meryglez529-commits/DAHUASUO/AI-work/LOG.md

# AI-work Log

> 2026-08-05 | DL5_UNIT_007 board ILA PASS | With the qualified recovery-acknowledgement image, the host app stopped/configured/read back/started the 16x16 laser profile: `dac_sample=50`, recovery=5 us, X fall=1 us, scan delay=800 ns, and 20 ns acquisition delay/time. Guarded three-ILA capture proves DAC tail marker/toggle, then State 18 for exactly 625 eth_clk cycles (5.000 us) before the next accepted laser; intervening laser edges were ignored. Laser camera_line_sync is low for the complete 31 us line window and acquisition delay/high each last four ui_clk cycles (20 ns). Hardware-manager run exited 0 with no D-root spill.

> 2026-08-05 | DL5_UNIT_007 qualified build | The physical-flyback recovery RTL was built through implementation and one checkpoint-based physical optimization repair. Final timing is WNS +0.093 ns, WHS +0.048 ns, TNS/THS 0; bitgen completed with 0 error/0 critical warning. The qualified paired files are `DL5_UNIT_007/out/bitstream/ETH_TOP_dl5_recovery_ack_qualified.bit/.ltx`. Added a unit-local guarded ILA plan which captures the DAC tail marker/toggle, eth-domain acknowledgement/recovery state, camera signal, and unchanged acquisition path. The subsequent board result is recorded in the newer log entry; no FIFO IP, register map, XDC, or IO changed.

> 2026-08-05 | DL5_UNIT_007 physical-flyback recovery implementation: Added a laser-only FIFO[32] final-flyback marker, DAC-domain completion toggle, three-FF return CDC, and States 17/18 so the configured recovery starts only after the physical final flyback word updates DAX. The standalone dual-clock regression passed normal, ultrafast, and laser cases; with a 1 us setting, completion-to-State14 measured 1.042 us. No FIFO IP, register map, XDC, or top-level IO changed. Implementation/board verification remains pending.

> 2026-08-05 | DL1_UNIT_002 FIFO[32] and handshake check: Confirmed `fifo_bit32 = laser_mode_en ? 1'b0 : adc_tri`; laser-mode `dac_output` takes ADC trigger from `acq_pulse_ui`, not FIFO[32], so bit32 is functionally spare in laser mode. The existing eth-side generator sees only `para_config_prog_full` and `wr_rst_busy`; it has no reader-empty, DAC-word-consumed, or DAX-level-complete input. Thus current State2 has no hidden physical-output handshake. The recommended acknowledgement changes the eth counter's start event, not its clock domain; counter-only scaling cannot supply that event.

> 2026-08-05 | DL1_UNIT_002 recovery-fix architecture choice: Compared counter-only and physical-completion approaches. Normal mode's State2 is also eth-clocked; its 5 µs physical dwell comes from enqueuing 250 DAC words, not a DAC-domain counter. Scaling laser State2 from 250 to 625 eth cycles is only an unbounded heuristic because its start still overlaps FIFO/DAC flyback. Recommended future fix: preserve FIFO width/depth and sparse recovery writes; make the DAC read side acknowledge actual tail consumption, then count recovery in eth_clk from that acknowledgement (625 cycles for 5 µs). A laser-only FIFO[32] tail marker plus one DAC→eth toggle is the minimal robust implementation; FIFO[32] is already forced to zero and ignored for ADC in laser mode. No RTL changed pending user approval.

> 2026-08-05 | DL1_UNIT_002 recovery defect root cause: State2 itself does correctly ignore laser; the failure is premature State2 exit. `dacx_recovery_time=5` becomes 250 intended DAC words, but laser State2 emits only two anchor words and advances its counter on the 125 MHz FIFO write clock, so it remains in State2 for only 250×8 ns=2 µs. It starts after the tail is generated on the write side, not after that tail has been consumed by the 50 MHz DAC read side. State2 therefore overlaps physical flyback, then explicitly enters State14, which accepts laser. The defect is a write-side timebase/physical-output-completion mismatch, not an unexpected laser transition within State2.

> 2026-08-05 | DL1_UNIT_002 recovery-time clarification: Confirmed the physical distinction in the current 1 µs flyback / 5 µs recovery setup. The next x0 word (also -4 V, hence invisible in DAX) reaches the DAC about 4 µs after the analog flyback reaches -4 V; the next visible x1 step is about 6 µs after it. The first accepted next-line laser occurs even earlier, before x0 output. Thus the current logic violates the required ≥5 µs post-flyback laser-inhibit interval despite a seemingly long -4 V plateau.

> 2026-08-05 | DL1_UNIT_002 step-count and latency review: Confirmed that a 16-pixel X line has 16 stable DAC levels but only 15 visible inter-pixel transitions; x0 equals the post-flyback start code, so its transition is hidden in the recovery plateau. User's live-scope laser-to-visible-DAX delay of ~1.24 µs is consistent with `scan_delay=100` (=800 ns from synchronized laser acceptance to State16 write) plus the fixed CDC/FIFO/DAC-output chain (~0.43 µs). The delay register is not a direct physical output-delay setting.

> 2026-08-05 | DL1_UNIT_002 confirmed laser recovery defect: User clarified the required semantics: with 1 µs X flyback and 5 µs recovery configured, the board must not respond to the first next-line laser until at least 5 µs after flyback completes. Source and ILA/scope evidence show the current laser State2 counter runs concurrently with FIFO/DAC flyback and then accepts laser too early; this is a confirmed RTL defect, recorded as Q22. No RTL changed in this turn.

> 2026-08-05 | DL1_UNIT_002 laser recovery semantics: Source review corrected the earlier shorthand “line-head recovery 5 µs”. Register `dacx_recovery_time=5` is intended to be an additional 5 µs recovery after flyback in normal mode, but laser State2 writes only two anchor FIFO words and counts 250 `eth_clk` cycles (=2 µs). Board ILA measures 5.02 µs from line-end marker to next line-start marker, including ~1 µs flyback and ~4 µs post-flyback hold for this laser phase. This is an implementation semantic deviation to assess separately; no RTL changed.

> 2026-08-05 | DL1_UNIT_002 scope CSV review: Reviewed user exports `F:/smart/csvwave/0909010011.csv` (CH1) and `0909010013.csv` (CH2). CH1 measures a stable 2 µs-period / 1 µs-high laser waveform. Conditional on the user's CH2=DAX probe mapping, CH2 shows the expected 16-code, 2 µs-per-code X line, ~1 µs flyback, and 36 µs line period. The files carry no physical-probe labels and were exported 18 s apart, so they cannot establish laser-to-DAC delay or camera-sync alignment; recorded this limitation in `SCOPE_REVIEW.md`.

> 2026-08-05 | DL1_UNIT_002 board ILA verification: Programmed repair bitstream, applied/read back the proven 16×16 laser profile (`dac_sample=50`, DL5=`100/20/80/30/60`) and started scan. Guarded ILA captured full write-side line, DAC marker/camera alignment and acquisition timing with zero D-root spill. FIFO[34]/[33] aligned with first/last DAX words; camera low window covered the full valid line and released on the first return code. Acquisition delay/width measured 600 ns/1.2 µs as configured. Evidence: `features/camera_line_sync/DL1_UNIT_002/BOARD_VERIFICATION.md`.

> 2026-08-05 | DL1_UNIT_002 implementation: After the focused RTL simulation PASS, rebuilt without changing FIFO/IP/XCI/XDC. `write_bitstream` completed successfully; formal timing WNS=+0.202 ns/WHS=+0.048 ns and all user constraints met. Archived the matched `ETH_TOP_camera_marker_fix.bit/.ltx`, reports, and guarded ILA capture script. Board-level laser capture remains pending user programming and start.

> 2026-08-05 | DL1_UNIT_002 RTL and simulation: Implemented the laser FIFO[34]/[33] marker-register alignment in `parameter_dacdata_gen.v`. The focused real-generator/DAC-output simulation passed at 3630 ns for laser `dac_sample=1/4/50` plus normal/ultrafast regression. After PASS, reused the existing-width DAC ILA probe2 for `{laser_mode, camera_active, FIFO[34], FIFO[33]}`; no FIFO/IP/XDC/register/board change. Implementation and guarded board capture remain pending.

> 2026-08-05 | DL1_UNIT_002 laser-camera repair plan: Created a corrective work package for the confirmed laser FIFO marker-alignment defect. The proposed minimal repair aligns FIFO[34]/[33] with the registered DAX/DAY and `wr_en` pipeline in State16, retains the DAC-domain line state machine, FIFO/IP/XDC/registers and normal/ultrafast behavior, and defines simulation/ILA/scope gates. No RTL, bitstream, or board configuration was changed.

每次 skill 调用或重要改动追加一行。最新的写在最上面。

格式：`YYYY-MM-DD HH:MM | mode | 简述`

---

| 时间 | Mode | 简述 |
|---|---|---|
| 2026-07-02 | host-protocol-ai-assist-design | 调用 fpga-cowork 讨论上位机联调优化：建议以确定性协议解析器/Wireshark 导出为底座，将抓包结构化后交给 AI 做字段解释、期望值对照、异常定位和复现建议；本轮只做方案分析，未修改功能代码。 |
| 2026-07-02 | docs-read-host-co-debug | 调用 fpga-cowork 复核 AI-work 文档，重点梳理上位机环境、UDP 控制面、DL2 数据接收、DL5 L0-L9 联调步骤及文档/源码一致性；仅阅读与记录，不修改 RTL 或上位机功能。 |
| 2026-06-22 12:40 | cleanup-and-skill-push | Cleaned D-root ILA spill: removed 21 empty `D:/hw_ila_data_*` dirs, verified D-root ILA-like dirs/files are both 0. Submitted fpga-cowork upstream update to GitHub repo `meryglez529-commits/fpga-project-reader`, commit `03eac32 Guard Vivado ILA D-root artifacts`, covering guarded Vivado ILA launcher policy and D-root spill archive rule. |
| 2026-06-22 12:25 | ila-artifact-guarded-runner | Added `AI-work/scripts/run_vivado_ila_guarded.ps1` as the required AI-driven ILA Vivado launcher. It runs Vivado batch from a unit-local work dir, writes logs/journals under the selected out dir, snapshots `D:/hw_ila_data_*`, and archives only newly-created D-root spill dirs into `droot_spill/`. Updated ILA_ARTIFACT_CONTROL.md and fpga-cowork skill to require the guarded launcher instead of direct `vivado.bat -source` calls. |
| 2026-06-22 12:15 | ila-artifact-root-cause-repro | Reproduced D-root hw_ila_data spill with Vivado batch. `refresh_hw_device` from `pwd=D:/` created `D:/hw_ila_data_22`; repeat after archiving re-created it. Controlled `upload_hw_ila_data` also created `D:/hw_ila_data_22` despite active pwd under AI-work, so cd alone is insufficient. Root cause: Vivado 2021.1 Hardware Manager ILA data-object handling (`display/get/upload_hw_ila_data`) can emit D-root placeholders. Added repro logs/README, updated ILA_ARTIFACT_CONTROL.md, and added D-root spill auto-archive guards to current capture scripts. |
| 2026-06-22 11:55 | ila-artifact-verification | User challenged Tcl pwd assumption after observing Vivado GUI pwd=C:/Users/Administrator/AppData/Roaming/Xilinx/Vivado. Corrected documentation from proven root cause to working hypothesis and added AI-work/scripts/probe_ila_workdir_behavior.tcl to verify whether refresh_hw_device creates hw_ila_data_* under D:, AppData, or a controlled work dir. |
| 2026-06-22 11:45 | ila-artifact-control | Reframed ILA artifact finding as observed facts plus working hypothesis: D:\ root has 21 empty hw_ila_data_* dirs from 2026-06-18 14:50:51, but current Vivado GUI pwd is C:/Users/Administrator/AppData/Roaming/Xilinx/Vivado, so D-root creation is not proven by current pwd alone. Updated current ILA scripts to resolve proj_root from [info script] and cd to unit-local vivado_hw_work; documented verification test in env/ILA_ARTIFACT_CONTROL.md. |
| 2026-06-22 11:20 | ila-artifact-audit | Scanned D: for ILA artifacts without moving files: D:\ root has 21 empty hw_ila_data_* dirs and no loose .ila/.wdb/.wcfg/.vcd/.csv/.bit/.ltx files; current project ILA evidence is mainly under AI-work/out plus Vivado-managed .Xil and AXI_DDR.hw wave/backup state; large unrelated cache is under stable_version projects. |
| 2026-06-22 10:45 | ultrafast-sync2-rtl-check | 检查超快模式 sync1 有输出、sync2 无输出现象相关 RTL：当前源码中 `sync2_pixel_tri_wigth` 写地址为 `0x0205`、读回同地址；若 `0x0205` 保持 reset 默认 1 或被写成 0/1，`parameter_dacdata_gen` 源脉冲/`dac_output` 整形器不会产生可见 sync2。顶层 `TRIGGER_OUT=sync_pixel_tri2` 直连，sync2 高有效；优先读回 `0x0205` 并用 ILA 看 `sync2_pixel_tri_r1/sync2_state/sync_pixel_tri2_reg`。 |
| 2026-06-22 10:10 | DL5-UNIT005-cleanup | 整理散落运行产物：工程根目录 `vivado*.log/.jou/.str`、`xvlog.pb`、`xsim.dir` 归档到 `DL5_UNIT_005/out/artifact_cleanup_20260622/project_root/`；非 unit 的 `AI-work/features/DL5_laser_sync/ila/*.csv/*.vcd` 归档到 `DL5_UNIT_005/out/artifact_cleanup_20260622/legacy_feature_ila/`；未移动 Vivado 管理目录 `.Xil/`、`AXI_DDR.hw/`、`AXI_DDR.runs/`、`AXI_DDR.sim/`。 |
| 2026-06-18 16:18 | DL5-UNIT005-board | Built and programmed fixed DL5 bitstream; `impl_1` write_bitstream PASS with WNS 0.007947 ns/WHS 0.049464 ns. ILA `hw_ila_9` after host parameter setup captured one `adc_tri_r1`, one 10-sample `acq_en` window, then `state=0` for the rest of capture. |
| 2026-06-18 15:24 | DL5-UNIT005-fix | Fixed DL5 laser-mode ADC free-run in `adcdata_acq.v`: non-row-end laser windows now return to trigger-wait state; added focused Vivado/xsim regression under `DL5_UNIT_005`, result PASS with logs/WDB in `out/sim/`. |
| 2026-06-12 17:40 | host-app-adc-image | Implemented ADC imaging v1 host side: DL2 AA55 parser, UDP 32001 receiver, frame assembler, channel-count-to-bitmask mapping, ADC Imaging GUI tab, mock image display, and protocol/channel tests. |
| 2026-06-12 17:05 | rtl-protocol-read | Checked `line_count/line_count_en`: generated in ADC acquisition for ultrafast/laser row completion, but `LAN_TX_FREAME` only emits `CC55` line-count packets when `ultrafast_mode==1`; laser imaging can initially rely on AA55 frame byte reconstruction. |
| 2026-06-12 16:45 | data-path-read | Read ADC imaging path for host-app planning: `adcdata_acq` trigger/average, `adcdata_get` channel packing, DDR FDMA buffering, `LAN_TX_FREAME` AA55 packetization, and existing host `core/data` stubs. |
| 2026-06-12 15:20 | host-app-gui | 重新核对 ADC 量程映射：不再只依据 `ETH_TOP.v` 的乱码注释，而是结合 `sem-scsg2450-afea-v10(2).pdf` AIN1~AIN4 原理图页，确认硬件继电器状态 `RL1/2` 为 `00=+/-5V`、`01=+/-2.5V`、`1x=+/-1.25V`；再套用 RTL `AINx_RELAY={~(|adc_gain), adc_gain[0]}`，得到 GUI code 显示应为 `0->+/-1.25V`、`1->+/-2.5V`、`2->+/-5V`、`3->+/-2.5V(same)`。已更新 ADC 下拉框，默认 code2 显示 `+/-5 V`。验证：compileall PASS、23 项 unittest PASS、Qt offscreen 检查 ADC/DAC 下拉文本和底层 code 正确。 |
| 2026-06-12 14:39 | host-app-gui | 核对 RTL 后更新 GUI ADC/DAC 量程显示：`ETH_TOP.v` 中 ADC `0x0003` code 控制 AINx 继电器，注释映射为 `00=5V/1/2x`、`01=2.5V`、`1X=5V`，因此 ADC 默认 code2 显示为 `5 V (1x)`；DAC `dac_gain[1]` 控制 `AOUTx_CON` 量程组、`dac_gain[0]` 进入 `ad9747_cfg.v` 选择 12.5mA/25mA，GUI 显示为 `1.25 V/2.5 V/5 V/10 V`，默认 code3 显示为 `10 V`。底层写入 code 不变。验证：默认 Python 与 `D:\fpga_host_venv` 均 compileall PASS、23 项 unittest PASS；Qt offscreen 确认 ADC/DAC 文本和底层 code 正确且 1120x752 无横向滚动。 |
| 2026-06-12 11:38 | host-app-gui | 取消 GUI 数字输入框的上下箭头步进按钮：模式工作台、顶部连接栏和高级调试旧面板中的所有 `QSpinBox` 均设置为 `NoButtons`，保留键盘直接输入，避免白色箭头控件突兀且减少误点加减 1。验证：默认 Python 与 `D:\fpga_host_venv` 均 compileall PASS、23 项 unittest PASS；Qt offscreen 检查完整窗口 32 个 SpinBox 均为 NoButtons，1120x752/1920x1080 横向滚动最大值仍为 0。 |
| 2026-06-12 11:32 | host-app-gui | 根据反馈收敛 GUI 配色：撤掉参数组大面积浅色和粗彩色边框，恢复中性仪器灰白底；仅保留关键交互点颜色标识，包括默认/应用参数按钮、开始扫描、停止扫描、模式/参数状态 chip 与 dirty 参数行。验证：默认 Python 与 `D:\fpga_host_venv` 均 compileall PASS、23 项 unittest PASS；Qt offscreen 检查默认激光参数仍正确，1120x752/1920x1080 横向滚动最大值仍为 0。 |
| 2026-06-12 11:28 | host-app-gui | 设置 GUI 激光联调默认值并优化视觉层次：默认进入“激光同步”，参数设为已上板验证的小帧配置（rows=6、cols=8、ADC 通道=1、X/Y 全幅、recovery=1us、fall=1us、scan/blanker/acq 时序均为 10）；增加全局 Fusion/QSS 样式，按参数组设置轻量色条和浅底色，减少单调灰；压缩顶部连接栏 IP/端口/按钮宽度，缓解窄窗口挤压。验证：默认 Python 与 `D:\fpga_host_venv` 均 compileall PASS、23 项 unittest PASS；Qt offscreen 检查 1120x752/1920x1080 默认值正确且横向滚动最大值为 0。 |
| 2026-06-12 11:19 | host-app-gui | 二次收紧上位机单页布局：压缩参数行 label/unit/hint 宽度和 group 边距，保持 3 列但避免 1120 宽度横向溢出；将“激光使能”合并到“激光同步 / 时序”组第一行；点击日志“清除”时同步清空底部 status 文案，避免误认为日志未清。验证：默认 Python compileall PASS、23 项 unittest PASS；`D:\fpga_host_venv` 下 compileall PASS、23 项 unittest PASS；Qt offscreen 检查 1120x752 与 1920x1080 下模式页横向滚动最大值均为 0。 |
| 2026-06-12 11:09 | host-app-gui | 按现场调试反馈调整上位机 GUI：模式工作台移除内层“共用参数/模式参数”双页，改为单页滚动布局，三列压缩共用参数并在下方直接显示当前模式参数；日志面板新增“清除”按钮并限制最多保留 500 行，计数随保留日志同步；去掉 REAL 模式下“应用参数/开始扫描”的反复确认弹窗。验证：默认 Python compileall PASS、23 项 unittest PASS；`D:\fpga_host_venv` 下 compileall PASS、23 项 unittest PASS、Qt offscreen smoke PASS。 |
| 2026-06-12 10:56 | host-app-board-debug | 核对 RTL 中 `dax_fall_us` 1us/2us 对下降回扫的影响：`command_monitor_new.v` 将 GUI 值写入 `0x000F`，`dacdata_config.v` 内部 x50 转为 FIFO word，因此 1us=50 word、2us=100 word；`parameter_dacdata_gen.v` State 12/13 下降段单调减 `dax_fall_step`，但 laser 模式 State 13 限速为约 3 个 eth_clk/word（约 41.67MHz）低于 `dac_output.v` 的 50MHz 读侧，2us 更容易耗尽 FIFO 余量并触发 `prog_empty` 读暂停，表现为 DAX 下降段保持/不均匀/毛刺；建议 ILA 对比 1us/2us 捕获 `para_config_wr_en/prog_empty/rd_en/DAX_DATA/current_state/dax_fall_cnt/s13_wait_cnt`。 |
| 2026-06-12 10:49 | host-app-board-debug | 解释 DAX 行尾下降和行首恢复时间：GUI `dax_fall_us` 写 `0x000F`，`dacdata_config` 内部 x50 转 FIFO/DAC word，名义上 1us->50 word、2us->100 word；GUI `dacx_recovery_us` 写 `0x0006[15:0]`，`parameter_dacdata_gen` 内部同样 x50。用户将两者从 2us 改到 1us 后，示波器光标量到下降约 1.020us，符合预期；laser 模式下行首恢复期间会忽略 laser，DAX 低平台还可能包含恢复结束后等待下一次 laser 的时间。 |
| 2026-06-12 10:42 | host-app-board-debug | 解释当前 laser 配置下最后一个 DAX 台阶宽度：`--dac-sample 20` 决定 State 16 写 20 个 DAC FIFO word，按约 20ns/word 预计最后台阶保持约 400ns；行内非最后台阶还会在 State 14 等下一次 laser 时继续保持，因此看起来更长。用户图中约 440ns 的最后台阶与该预期量级一致。 |
| 2026-06-12 10:34 | host-app-board-debug | 用户更新新 bitstream 后，host-app `mode laser apply` 和 `start` 均成功，`0x0009=0x00000011` running。示波器图显示 CH2 laser 触发下 CH1 DAX 呈 `cols=8` 对应的 8 级台阶，行末出现回扫/下降后进入下一行，形态与 `parameter_dacdata_gen` 激光模式 State 14/15/16 -> State 4 -> State 12/13 的预期一致；建议继续用光标确认 laser->DAX 首台阶延时约为 `scan_delay=10` 的 80ns 加 FIFO/DAC 输出链路固定延迟，并用 TRIG_BLANK/ADC acq 进一步闭环。 |
| 2026-06-12 10:01 | host-app-board-debug | 查看用户 GUI 日志：version 读回 `0x000300AC`，但 `mode laser apply` 失败。dry-run 展开当前写入计划为 22 个 checked-write；源码 `command_monitor_new.v` 已按 `0x020B=laser_mode_en`、`0x0200~0x0205` 读回更新，但当前 `ETH_TOP.bit` 时间戳为 2026-06-05 09:55，早于 2026-06-11 的寄存器协议源码更新，判断板上 bitstream 大概率仍是旧协议，需重出/重烧 bitstream 或临时按旧 `0x0205=laser_mode_en` 调试。 |
| 2026-06-11 15:45 | feature-host-app-param-gui | 准备提交到 GitHub：本次提交聚焦 `command_monitor_new.v` 读回表、host-app 参数模型/CLI/GUI 两页重构、参数单位/地址文档和测试；不包含无关 `skill-improvements` 与 artifact cleanup 工作区文件。 |
| 2026-06-11 15:25 | feature-host-app-param-gui | GUI 参数区改为两页：`共用参数` 包含图像/采样、扫描区域、时序、增益/行帧；`模式参数` 随普通/超快/激光切换；移除可编辑 scan_mode，固定 code 1；DAC X/Y 起止改为 0..cols-1 / 0..rows-1 人类坐标并在 GUI 内转 16-bit DAC code；超快/激光不再使用普通 adc_interval。 |
| 2026-06-11 14:45 | feature-host-app-param-gui | 复查 GUI 参数语义：核对 `adc_interval`、`scan_mode`、DAC X/Y code 到顶层取反输出、`dacx_recovery_time/dax_fall_time` x50、`frame_waiting_time`、`row_m/row_n` 交错扫描，以及激光模式 `acq_data_delay_time` 与 ADC 采集延时分层关系。 |
| 2026-06-11 14:10 | feature-host-app-param-gui | 按 `UX_REDESIGN_PLAN.md` 实现 host-app GUI V1：窗口标题去 Qt backend、顶部连接栏分组、模式下拉替代左侧单选、普通模式隐藏空扩展页、参数页重分组并外显单位/换算、运行控制上移、写入计划/日志改抽屉；`compileall` PASS、23 项 `unittest` PASS、Qt offscreen smoke PASS。 |
| 2026-06-11 13:05 | feature-host-app-param-gui | 检查当前 PySide6 GUI 与用户列出的 UX 问题，新增 `UX_REDESIGN_PLAN.md`：给出顶部栏、模式下拉、参数 metadata、动态 Tab、运行工作条、写入计划/日志抽屉的重构方案；同步修正 `PARAM_UNITS_AUDIT.md` 中 `0x0205` 读回旧备注。 |
| 2026-06-11 12:35 | feature-host-app-param-gui | 补 `command_monitor_new.v` RTL 读回表：`0x0200~0x0205` sync/ultrafast 与 `0x020B` laser enable 可读回；host-app register map/mode plan 改为 checked write；清理 host-app 架构/UX/ready 文档中对应旧不可读回描述；`compileall`、23 项 `unittest`、laser dry-run PASS。 |
| 2026-06-11 12:10 | feature-host-app-param-gui | HOSTAPP_UNIT_001：按当前 `command_monitor_new.v` 写表更新 host-app 地址与参数模型（`0x0205=sync2_width`, `0x020B=laser_mode_en`），补 gain/frame/row 参数、GUI 分组与单位标签、CLI help、单位审计文档；`compileall` PASS，23 项 unittest PASS，laser/ultrafast dry-run 确认 write-only 地址 unchecked。 |
| 2026-06-11 10:00 | single-file-close-read | 精读 `command_monitor_new.v` 的 DL4 写/读寄存器表，并对照 `AI-work/host-app` 当前 GUI/CLI/mode 写入计划；新增 `AI-work/host-app/COMMAND_MONITOR_PARAM_COVERAGE.md`，标出普通扫描已覆盖参数、raw-only 参数，以及当前 RTL `0x0205/0x020B` 与 host-app 的 DL5 laser enable 地址冲突；未修改 RTL/host-app 代码。 |
| 2026-06-11 09:52 | context-read | 使用 AI-work 平台复核工程地图与 host-app：确认当前顶层 `ETH_TOP`、DL1~DL5 链路状态；检查 `host-app` 架构/代码/配置，运行 21 项 unittest、`compileall`、Qt import、normal/laser dry-run 和 DL2 mock-frame；未修改 RTL 或 host-app 代码。 |
| 2026-06-05 12:37 | artifact-cleanup | 整理 D 盘、`D:\SGSC_SEM_dahuasuo_325T_V3_172` 和工程根散落运行产物：57 项约 190.72 MB 移入 `AI-work/reports/artifact-cleanup-2026-06-05/`，清单见 `AI-work/env/ARTIFACT_CLEANUP_2026-06-05.md`；保留 Vivado 工程内部目录、安装包、压缩包和参考文档。 |
| 2026-06-05 11:57 | skill-improvement | 接替并完成 `fpga-cowork` skill 改进收口：将原 `fpga-project-reader` skill 改名为 `fpga-cowork`，按 DL5_UNIT_002 原型固化 Mode 5 阶段式闭环、Mode 4 项目级仿真 SOP、feature 工作包模板、validator 和产物散落扫描基线选项；未修改 RTL。 |
| 2026-06-05 10:45 | DL5-UNIT004-board-verify | Completed board-level ILA measurement for `laser_pulse_ui -> acq_delay -> acq_pulse_ui/acq_time`: cfg `0x0005000A`, delay counter `0..19` (20 ui_clk cycles), acq counter `0..39` (40 ui_clk cycles), result PASS. Added export script and final measurement docs. |
| 2026-06-05 09:32 | DL5-UNIT004-sim | Completed DL5_UNIT_004 full Vivado/xsim regression after auditing DUT-vs-testbench contract. TC1-TC15 PASS, total errors 0, RTL unchanged in this completion pass; patched regression TB/script handling for line_count contract, auto-row acquisition, acq_time edge counting, and PASS marker parsing. |
| 2026-06-05 09:14 | DL5-UNIT004-audit | Audited simulation and ILA evidence for DL5_UNIT_004: full regression result is FAIL; short smoke sim PASS only; adcdata1_acq ILA probes enumerate on hw_ila_9 but latest batch capture has no CSV and reports debug-core/trigger failure. |
| 2026-06-03 19:30 | DL5-UNIT003-board-debug-closed | **DL5 上板调试闭环**：blanker 无输出 → 逐层定位出两个独立问题并全部解决。(1) **host-app 漏写扫描几何寄存器**：`ScanConfig.to_registers()` 只写 `0x0001/0x0002/0x0004/0x0009`，从不写 `0x0005/0x0006/0x0007/0x000F`，导致 `0x0006` 不写 → `dacx_step` 除法器(`dacx_step_flag`)从不触发 → DAX 恒 0x8000、普通模式 DAC 也无波形。修 `scan.py`+`modes.py`(补全几何寄存器，固定内置默认值)，21 单测过。(2) **D15/laser_sync_in 硬件输入问题**：ILA 直抓 `TRIGGER_IN_IBUF` 实测恒 0(对照内部注入脉冲 33 个完美上升沿)，铁证锁定板级物理层；用户修复硬件后复测 `TRIGGER_IN_IBUF` = 500kHz/20%/2µs，与信号源吻合。mux 改回真实 `TRIGGER_IN` 端到端验证：示波器 TRIG_BLANK 有输出，ILA 实测 laser_sync_in 20% 占空比、laser_toggle 翻转、状态机 14→15→16→4 循环、blanker 整形器输出正常。延迟指标上板实测与仿真吻合(blanker 脉宽 500ns、laser→DAX ~256ns vs 仿真 274ns、跨行 20ns vs 仿真 48ns、FIFO 水位 80% 在地板)。清理全部调试代码(顶层注入+ila_top_trig+dl5_dac_diag)，重出正式 bitstream |
| 2026-06-03 09:51 | DL5-UNIT003-board-bringup | bitstream 烧录后开始实板 L0-L5 联调：`192.168.1.8` ping/UDP version 通，版本 `0x000300AC`；先 `stop` 得到 `0x0009=0x00001310`，随后写入激光模式并启动，参数读回为 `0x0205=1, 0x0206=10, 0x0207=100, 0x0208=100, 0x0209=30, 0x020A=25`，扫描状态 `0x0009=0x00000011`；等待示波器确认 D15、TRIG_BLANK、TRIGGER_OUT |
| 2026-06-02 17:20 | host-app-L0-L9-readiness | 检查 `AI-work/host-app` 对 DL5_UNIT_003 L0-L9 上板验证的支持度：21 项 unittest 通过，CLI dry-run 确认普通/激光模式写入计划正确；新增 `HOST_APP_L0_L9_READINESS.md`；同步修正 `BOARD_DEBUG_GUIDE.md` 中版本寄存器和 DL5 地址旧表（laser_mode_en 为 0x0205，version 为 0x000A） |
| 2026-06-02 17:11 | DL5-UNIT003-docs | 更新 `BOARD_DEBUG_GUIDE.md`：明确当前状态为 route_design 已通过、下一步直接 write_bitstream；修正原文中把 `run_implementation.tcl` 当作 bit 生成脚本的问题；新增 `run_bitstream.tcl` 用于生成并归档 `ETH_TOP_unit003.bit` |
| 2026-06-02 17:03 | DL5-UNIT003-impl | 新增并运行 `run_implementation.tcl`，`impl_1` 跑到 `route_design Complete!`（12 分钟）；routed timing 通过：WNS=0.091 ns、TNS=0、WHS=0.052 ns、THS=0，0 setup/hold failing endpoint；bus skew 全部正 slack；`laser_sync_in` NSTD/UCIO DRC 未复现，下一步可 write_bitstream |
| 2026-06-02 16:26 | DL5-UNIT003-synth | 复用 `TRIGGER_IN`/D15 后重跑完整 synthesis：`synth_design` 完成，0 ERROR / 0 CRITICAL WARNING；旧 `laser_sync_in` NSTD/UCIO DRC 已消除；synthesis WNS 仍为 -0.622 ns，最差 setup 路径为 `U6/N1/step_count_reg[15]` → `U6/N1/day_level_reg[63]`，记录为 implementation 前的时序风险 |
| 2026-06-02 15:45 | DL5-UNIT003-pin-reuse | 按用户确认复用 `TRIGGER_IN`/D15/LVCMOS33：普通/超快模式保留原 TRIGGER_IN 行触发语义，激光模式下同一物理输入作为 `laser_sync_in`；移除顶层独立 laser_sync_in 物理端口，Q19 resolved |
| 2026-06-01 10:47 | host-app-gui-safety | 落地 UI 第一性原则中的 P0/P1：模式工作台新增参数 dirty 状态、失败态 start 防护、REAL 模式 apply/start 确认、`0x0009` scan 状态读回、GUI 操作等价 CLI 日志、写入计划地址展开开关；连接栏新增网络诊断；验证 21 项 unittest、compileall、CLI mode dry-run、GUI 行为小测试通过 |
| 2026-06-01 10:35 | host-app-ui-principles | 参考 ISA-101、FDA human factors、LabOne、Windows design basics、Qt HMI 资料，从第一性原理重新梳理上位机 UI；新增 `HOST_APP_UI_FIRST_PRINCIPLES.md`，明确 UI 是仪器控制台而非寄存器编辑器，并定义状态、模式、日志、防错、DL2/3 扩展和验收标准 |
| 2026-06-01 10:01 | host-app-gui-v2 | 按用户确认实施 GUI V2：新增模式工作台和顶部连接栏，主流程改为普通扫描/超快扫描/激光同步三种模式；raw register console 移到高级调试；补齐 V2 实现记录，验证 21 项 unittest、compileall、CLI mode dry-run、GUI instantiate 均通过 |
| 2026-06-01 09:48 | host-app-ux-plan | 根据用户试用 GUI 反馈，新建 `HOST_APP_GUI_UX_V2_PLAN.md`：将 V2 GUI 定位为以人为本的三模式工作台（普通/超快/激光），主流程隐藏寄存器地址，寄存器控制台降级为高级调试；补充三种模式的参数、写入流程、防呆规则和 V2-P0~P7 改造计划 |
| 2026-06-01 09:40 | host-app-env | 检查并安装上位机 Python 环境：系统 Python 3.12.10/64bit 可用；因工程路径过长导致本地 `.venv` 安装 PySide6-Essentials 触发 long path，改用短路径 `D:\fpga_host_venv`；已安装 editable `fpga-host 0.1.0`、PySide6_Essentials 6.11.1；CLI、GUI import、UDP 32000 bind、17 项 unittest 均通过；新增 `HOST_APP_ENVIRONMENT.md` 实板测试命令 |
| 2026-06-01 09:10 | host-app-implementation | 实现 `AI-work/host-app` 第一版 P0-P6：Python package 骨架、DL4 protocol/register map/register client、real UDP + mock transport、scan/DL5 device API、CLI、PySide6/PyQt GUI 面板、DL2 data-plane stub/mock、configs 和 unittest；17 项单测通过，CLI mock 验证通过；当前环境缺少 Qt binding，GUI 未启动实测，真实 FPGA UDP 未接板实测 |
| 2026-05-31 14:16 | host-app-architecture | 新建 `AI-work/host-app/HOST_APP_ARCHITECTURE.md`：固化 PySide6/PyQt 上位机的分层架构、目录骨架、core/GUI/CLI/mock 边界、DL4 协议模块、DL2 数据平面预留、测试策略和开发阶段；在选型文档中补充架构文档链接 |
| 2026-05-30 17:21 | host-app-planning | 固化上位机第一版技术栈决策：Python Qt 路线（PySide6 优先、PyQt 备选）、原生 CLI、mock 模式、第一阶段不打包 exe；补充 DL2 快速接入的 control/data 分层和后台 worker/帧模型预留要求 |
| 2026-05-30 17:19 | host-app-planning | 根据用户倾向更新上位机选型文档：记录 Qt 路线，并区分 C++ Qt 与 PySide6/PyQt 两个分支；新增 mock 模式说明、模拟范围和工程价值 |
| 2026-05-30 17:18 | host-app-planning | 根据用户补充的 AI 协作需求，更新上位机选型文档：第一版明确为 GUI + 原生 CLI + 共享核心库，并记录 CLI 命令草案、JSON/dry-run/mock 等要求及 CLI-Anything 后续定位 |
| 2026-05-30 17:02 | host-app-planning | 新建 `AI-work/host-app/HOST_APP_DISCUSSION_AND_TECH_SELECTION.md`，记录上位机第一版范围、DL4 协议约束、技术选型候选方案、推荐路线和待用户决策问题 |
| 2026-05-30 16:49 | DL4-doc-update | 补充 `DL4_REG_CONTROL_DEEP_READ.md` 的上位机开发协议说明：网络端点/端口绑定、payload 编解码、读写确认策略、寄存器模型、普通扫描和 DL5 配置流程；同步更新 0x0205~0x020A 读写表 |
| 2026-05-30 16:45 | DL4-protocol-read | 阅读 DL4 寄存器控制链路和以太网协议栈源码，确认 UDP 32000 双向寄存器协议、payload 格式、读回格式、端口过滤和上位机绑定要求；未修改 RTL |
| 2026-05-30 16:39 | context-read | 阅读 AI-work 工作区，补充当前项目理解；重点核对 FPGA_PROJECT_GUIDE、env、DL1~DL5 文档与 UNIT_002 仿真记录，未修改 RTL |
| 2026-05-27 18:35 | DL5-UNIT002-plan | 补充 `DL5_UNIT_002/WORK.md` 实现方案草案：推荐复用 `0x020A` 为 `scan_delay_time`，由 `laser_sync_in` 触发 scan/blanker/acq 三窗口，`Scan_X_Signal` 仅作内部脉冲，`parameter_dacdata_gen` 由 scan_x 触发写 `dac_sample` 长度 FIFO burst；未修改 RTL |
| 2026-05-27 18:20 | DL5-UNIT002-requirements | 根据 PDF 截图和用户纠偏更新 `DL5_UNIT_002/WORK.md`：确认 dwell time 来自 `dac_sample`，每个 `laser_sync_in` 边沿后经 `scan delay` 产生 `Scan_X_Signal` 控制 DAC 坐标赋值，同时产生 blanker/acq 三窗口；未修改 RTL |
| 2026-05-27 18:03 | DL5-UNIT002-docs | 用户确认 UNIT_001 需求方向偏差；整理 UNIT_001 为历史实现包，并新建 `features/DL5_laser_sync/DL5_UNIT_002/` 作为第二轮需求对齐入口，当前未修改 RTL |
| 2026-05-27 14:40 | DL5-sim-replay | 验证 `features/DL5_laser_sync/DL5_UNIT_001/sim/run_batch.tcl`：脚本临时切 `target_simulator=XSim`，Vivado 2021.1 复跑 TC1-TC8 PASS，重新生成 `out/sim/result.txt`、`xsim.log`、`vivado_run_batch.log`、`waveform.wdb` |
| 2026-05-27 14:22 | DL5-doc-recovery | 按 `skill-improvements/fpga-project-reader-doc-management.md` 第 10 节补救 DL5：新建 `features/DL5_laser_sync/DL5_UNIT_001/`，整理 `WORK.md`、`RTL_REVIEW.md`、`SIM_REPLAY.md`、仿真/综合证据、Vivado replay Tcl，并把旧 `DL5_LASER_SYNC_MODE_DESIGN.md` 改为归档入口 |
| 2026-05-27 09:39 | env-maintenance | 通过真实 `winget.exe` 安装并验证 Python 3.12.10；`python`/`py`/`pip`/`winget` 在模拟新终端 PATH 下均可按命令名找到；回填 `ENVIRONMENT.md` |
| 2026-05-27 09:19 | env-maintenance | 更新 `ENVIRONMENT.md` / `SNAPSHOTS.md` 中的工程根路径为当前 `D:/SGSC_SEM_dahuasuo_325T_V3_172/.../fpga_prj`；当时 PATH 里的 Python/winget 均表现为 WindowsApps 占位入口，后续改用 App Installer 包内真实 `winget.exe` 处理 |
| 2026-05-22 17:24 | DL5-impl | Step 8c 完成：full synth_1 PASS（BUILD PASS, synth_design Complete），0 ERROR / 0 CRITICAL WARNING（整个综合日志）。资源占用：LUT 31.94%、Reg 27.19%、IOB 70.50%（+1 = laser_sync_in）、BRAM 89.89%（pre-existing，与 DL5 无关）、DSP 1.90%。Step 7 集成 sim 跳过（综合等价覆盖了接线/CDC 验证） |
| 2026-05-22 17:18 | DL5-impl | Step 8b 完成：RTL elaboration PASS（synth_design -rtl on AXI_DDR.xpr），0 ERROR / 0 CRITICAL WARNING，`laser_sync_blanker_ctrl` 干净综合，`laser_sync_in` 在顶层 port list。剩余 warning 均为 pre-existing（adcdata_config.data_en 未连接等） |
| 2026-05-22 17:15 | DL5-impl | Step 2~6 完成：parameter_dacdata_gen.v 加 laser mode 分支 + laser_pixel_written 标志；dac_output.v 加 4 个 DL5 输入端口 + 3 处 mux（adc_tri/sync1/sync2）+ ui_clk→dac_dco 同步；dacdata_config.v 例化 laser_sync_blanker_ctrl + 完整 CDC（双 FF + ASYNC_REG，toggle-FF pulse 同步）；command_monitor_new.v 加 6 个寄存器（0x0205~0x020A）+ 读写解码；ETH_TOP.v 加 laser_sync_in 顶层端口 + 6 个 wire。全部 xvlog 语法过 |
| 2026-05-22 17:00 | DL5-impl | Step 1 完成：新增 `laser_sync_blanker_ctrl.v`（3 态状态机 + 3 级 FF CDC + scan_state 门控）和 `tb_laser_sync_blanker_ctrl.v`（TC1~TC8）。xsim 跑通，8/8 用例 PASS，0 错误。仿真总时长 ~36us，wall-time < 1min |
| 2026-05-22 18:00 | design | DL5 v3：用户拍板 3 个 P0 决策（时钟用 ui_clk / blanker 低有效 / acq_data_delay_time 新建独立寄存器）。R1 用读 dac_output.v 现场确认（自保持 DAX/DAY）。文档对账"adc_tri 引脚"实际无 IO、纠正物理引脚名为 TRIG_BLANK / TRIGGER_OUT。Q13~Q14 已 resolved；新增 Q15~Q18 |
| 2026-05-22 17:30 | design | DL5 v2 修订：状态机改并行 3 态、新增 laser_period 寄存器（方案 B 切像素）、blanker/adc_tri/sync IO 全部复用现有引脚（仅 Laser Sync 新增 1 个输入）、sync2 语义=laser_event_busy。OPEN-QUESTIONS 加 Q12~Q14 |
| 2026-05-22 16:30 | design | DL5 飞秒激光同步模式架构 v1。用户决策：1 脉冲=1 像素 / IO 暂占位 / sync 跟随激光 / 不做超时。修正 acq 步进 20ns（原稿误写 5ns）。产出 guide/data-paths/DL5_LASER_SYNC_MODE_DESIGN.md |
| 2026-05-22 15:35 | annotation+focus | 对比 parameter_dacdata_gen 新旧版（旧版备份 vs 当前工程）：识别 3 项新增功能（sync_pixel_tri1/2、ultrafast 模式、dac_sample 32-bit）+ FIFO 35-bit。产出 annotations/parameter_dacdata_gen-diff.md，更新 FOCUS.md。用户意图：在新版基础上**新增一个新功能**（具体待告知） |
| 2026-05-22 15:10 | cowork-setup | Step 7: **RULES.md confirmed by user**。Mode 4 setup 完成，可进入闭环 |
| 2026-05-22 15:00 | cowork-setup | Step 6: check_env.tcl PASS（log 见 sim_out/check_env.log），SGMII license OK，1096 源文件齐全 |
| 2026-05-22 14:15 | cowork-setup | Step 5: 回滚演练通过（改 LOG.md → git checkout 还原），baseline tag = baseline-pre-cowork |
| 2026-05-22 14:14 | cowork-setup | Step 4: 复制 5 个 TCL 模板到 AI-work/scripts/，加 customization 头 |
| 2026-05-22 14:13 | cowork-setup | Step 3: 写 env/ 六份 .md（ENVIRONMENT/HARDWARE/RULES/FOCUS/SNAPSHOTS/GLOSSARY） |
| 2026-05-22 14:11 | cowork-setup | 挪旧产出：FPGA_PROJECT_GUIDE.md + 4 份 DL*_DEEP_READ.md + 2 份 HTML 到 AI-work/guide/，ADC_SPI_CONFIG_READ.md 到 annotations/ |
| 2026-05-22 14:10 | cowork-setup | Step 5: git init + commit baseline + tag baseline-pre-cowork（commit df52990） |
| 2026-05-22 14:08 | cowork-setup | Step 2: 用户回答 4 个关键问题（git/挪旧产出/DAC 焦点/xsim） |
| 2026-05-22 14:05 | cowork-setup | Step 1: 工具链探测完成（Vivado D:/Xilinx/Vivado/2021.1 OK；ModelSim 路径失效；GBK/UTF-8 混合；314GB 磁盘） |
| 2026-05-22 14:00 | bootstrap | 创建 AI-work 骨架，启动 Mode 4 co-work setup |
| 2026-08-03 | Mode 2 review | Reviewed the existing AI-work DAC package and re-traced the current RTL path for FIFO bits [34:33] (`sync_pixel_tri2/1`) through `dac_output` to TRIGGER_OUT/TRIG_BLANK; no RTL changes. |
| 2026-08-04 | DL1_UNIT_001 route result | Fresh project-managed synthesis passed (1m47, 0 ERROR/0 CRITICAL WARNING); `impl_1` completed through route_design with WNS +0.119 ns, WHS +0.053 ns, TNS/THS 0. No bitstream was generated. Routed reports and Vivado logs were archived under the unit. |
| 2026-08-04 | DL1_UNIT_001 bitstream | User authorized `write_bitstream` from the timing-closed routed implementation. Vivado completed successfully (0 ERROR/0 CRITICAL WARNING); `ETH_TOP.bit`, `.bin`, `.ltx`, logs, and status were archived under the unit. No Hardware Manager or board operation was performed. |
| 2026-08-04 | DL5 protocol diagnosis | Board symptom review found the legacy host writes laser enable at 0x0205, while current RTL maps 0x0205 to sync2 width and accepts laser_mode_en only at 0x020B. With 0x020B left zero, ETH_TOP gates TRIGGER_IN/D15 to zero for laser_sync_in; normal scan can still work. No RTL change made. |
| 2026-08-04 | DL5 live register read | Read the connected board through the project host app (read-only): version 0x000300AC, scan control 0x00003211, DL5 0x0206..0x020B = 100/20/80/30/60/1. Current laser_mode_en is asserted and timing values match dl5_test, so the stale-0x0205 hypothesis is ruled out for this live board state. |
| 2026-08-03 | architecture review | Evaluated a dedicated camera-sync output spanning normal, ultrafast, and laser modes. Proposed a mode-independent camera event plus ui_clk pulse shaper and a new physical output; no RTL changes. |
| 2026-08-03 | camera-line-sync analysis | Confirmed normal/ultrafast scan streams State 3 pixels continuously per line, whereas laser mode waits in State 14 and emits one State 16 pixel sequence per accepted laser edge. Refined proposal to a DAC-clock-domain line-valid sideband that holds through laser inter-pulse gaps; no RTL changes. |
| 2026-08-03 | camera-line-sync requirements | User confirmed camera line-sync: active-low, covering only valid pixels, asserted/deasserted once per scan line. Physical output pin and row-repeat interpretation remain to be confirmed before RTL work. |
| 2026-08-03 | camera-line-sync pin review | Reviewed MCON schematic and current constraints. Selected existing `TRIG_H` as the preferred camera line-sync route: it is presently tied low in RTL, maps to FPGA F15, and is constrained LVCMOS33. Row-repeat will emit one window for each physical scan pass. No RTL changes. |
| 2026-08-03 | camera-line-sync no-fifo-width design | Designed a no-FIFO-width-change variant: normal/ultrafast derive line-valid from existing FIFO[32]/adc_tri; laser mode reuses otherwise-zero FIFO[34] as line-start and FIFO[33] as line-end marker, with a dac_dco latch that holds through inter-laser gaps. Requires gating legacy sync1/2 consumers off in laser mode. No RTL changes. |
| 2026-08-03 | DL1_UNIT_001 setup | Created `AI-work/features/camera_line_sync/DL1_UNIT_001` Mode 5 package. Requirements, architecture, implementation plan, RTL review, simulation replay, artifact boundary, and evidence directories are ready; no RTL, XDC/IP, or tool-run changes. |
| 2026-08-03 | DL1_UNIT_001 docs | Per user request, rewrote the Mode 5 work-package documents in Chinese while retaining RTL signal names, paths, and commands. No RTL or tool-run changes. |
| 2026-08-03 | pre-DL1-unit cleanup | Archived scattered project-root Vivado/xsim artifacts (`vivado.jou`, `vivado.log`, `xvlog.pb`, `xsim.dir`) to `AI-work/reports/artifact-cleanup-20260803/`; preserved `.Xil`, Vivado-managed project directories, RTL, XDC/IP, and all user worktree changes. |
| 2026-08-04 | DL1_UNIT_001 implementation | Implemented the active-low camera line-sync path without changing FIFO width, XDC, IP, or register mapping. Normal/ultrafast use FIFO[32] in dac_dco; laser reuses FIFO[34]/[33] as start/end markers, with one-dac-clock delayed release. Added a focused unit-local simulation harness; simulation not yet run. |
| 2026-08-04 | DL1_UNIT_001 verification | Focused Vivado simulation PASS (normal, ultrafast, laser gaps/end, legacy sync isolation) and full-project RTL elaboration PASS. Independent `synth_design` completed with 0 ERROR/0 CRITICAL WARNING but timing failed (WNS -0.309 ns, WHS -1.254 ns) on pre-existing global paths; no implementation or bitstream was run. Root Vivado artifacts were moved into the unit and spill scan PASS. |
| 2026-08-04 | DL1_UNIT_001 implementation-run | User explicitly authorized refreshing the project-managed `synth_1` and `impl_1` runs to route the current camera line-sync RTL. Prepared a unit-local route-only script; no write_bitstream request. |
| 2026-08-04 | DL1_UNIT_001 live ILA | User requested live ILA diagnosis of laser mode. Prepared guarded unit-local capture for J9 laser input, laser UI pulse, and DAC trigger using the archived bitstream LTX; capture pending. |
| 2026-08-04 | DL1_UNIT_001 live ILA result | After unexpected power-off, guarded Hardware Manager reconnection succeeded but found no matching ILA cores with the current unit LTX. No waveform was captured; active FPGA image must be reprogrammed before diagnosis can continue. |
| 2026-08-04 | DL5 live ILA historical-template check | Reused the proven DL5_UNIT_005 `capture_postfix_ila.tcl` verbatim through the guarded launcher after the user reprogrammed and enabled laser mode. All 22 ILA cores resolved; UI ILA `hw_ila_18` armed on `laser_pulse_ui_1` and ADC ILA `hw_ila_9` armed on `adc_tri_r1`, but no UI trigger arrived during the observation. This localizes the live failure upstream of the UI laser pulse / ADC path; no RTL or register writes were made. |
| 2026-08-04 | DL5 laser input retest | User authorized host-app control. Prepared a guarded copy of the historical single-probe `check_laser_in.tcl`; it preserves the `U6/laser_sync_in == 1` trigger and will apply the already-read DL5 timing values through the project host app after arming. |
| 2026-08-04 | DL5 host-driven live ILA PASS | Host app successfully read back stop/disable/timing/enable/start sequence (`0x0206..0x020A=100/20/80/30/60`, `0x020B=1`, `0x0009=0x1311`). Historical input ILA captured 2-us `laser_sync_in` with matching CDC edges; proven UI/ADC ILA captured 2-us `laser_pulse_ui_1` and `adc_tri_r1`, plus 60-sample `acq_en` windows. Live laser chain PASS. |
| 2026-08-04 | DL5/camera oscilloscope plan | Documented staged laser-mode then camera-line-sync plan, including actual board connectors, low-active blanker/camera polarity, the external-laser-defined dwell constraint, and the fact that ADC acquisition timing requires ILA unless a debug IO mux is separately approved. |
| 2026-08-04 | DL5 test-plan clarification | Clarified that DAC X is the primary oscilloscope reference for scan delay and dwell, blanker remains a direct J19 scope check, and no unique root cause was proven for the historical transient blanker absence. |
| 2026-08-04 | DL5 reliability review | Reviewed current RTL and host protocol for intermittent blanker risk. Recorded confirmed `0x0205`/`0x020B` protocol incompatibility, blanker reset/zero-width RTL hazards, and missing hardware mode-transition interlock; no functional code change made. |
| 2026-08-04 | DL5 reliability disposition | User deferred the recorded DL5 reliability fixes until after overall testing. Risks remain open; no RTL, XDC, IP, or host behavior changed in this turn. |
| 2026-08-05 | DL5 scan-delay scope setup | Per user request, configured the live board for an observable laser-to-DAC-X scan-delay measurement: 16x16 frame, 4 samples/pixel, X=0x1999..0xE665, line-head recovery=5 us, X fall=1 us, scan delay `0x0206=100` (=800 ns). Stopped before geometry writes and restarted with `0x0009=0x00003211`; all written registers read back. Preserved existing blanker settings `0x0207/0208=16/100` (=80 ns/500 ns), acquisition `0x0209/020A=1/1` (=20 ns/20 ns), and laser enable `0x020B=1`. |
| 2026-08-05 | DAC output connector check | Verified RTL, XDC, and AFE schematic end-to-end: `DAX_DATA -> dac_p1d -> DAC_P1D -> DAC_OUT1 -> AOUT1/J7 (offset SMA)`; `DAY_DATA -> dac_p2d -> DAC_P2D -> DAC_OUT2 -> AOUT2/J8 (offset SMA)`. A 16-column, 2-us laser period produces one DAY step per 32-us line, so scope channel identification is essential for the scan-delay test. |
| 2026-08-05 | DL5 DAX scope anomaly | User measured DAX/AOUT1 with the 16x16 scope setup: line-head recovery about 15 us (configured 5 us), X fall about 880 ns (configured 1 us), laser-to-DAX about 1.2 us (800 ns configured delay plus fixed-chain latency), pixel dwell 2 us (matches laser period), only 11 visible X steps (configured 16), and a final rising spike. Live readback confirms `0x0004=0x00100010`, `0x0006=0x00100005`, `0x000F=1`, and `0x0206=100`; therefore the recovery/step-count/spike discrepancies are open RTL/analog-path issues, not a register mismatch. No RTL or hardware configuration was changed. |
| 2026-08-05 | DL5 acquisition timing recapture | Reapplied and read back the 16x16 laser scope profile, including `0x0206=100`, `0x0209=1`, `0x020A=1`, `0x020B=1`, and scan-start `0x0009=0x00003211`. Guarded ILA capture confirms UI acquisition delay count 0..3 followed by acquisition-window count 0..3: each is four 5-ns UI clocks (20 ns). ADC ILA sees `adc_tri_r1`, then the fixed pipeline states, then one ADC-clock-wide `acq_en`; raw CSV/VCD evidence is in DL5_UNIT_005/out/ila. |
| 2026-08-05 | DL5 DAX anomaly RTL diagnosis | Source review isolates a confirmed laser-mode recovery contract violation: State 2 counts `dacx_recovery_time*50` on `ui_clk`, but deliberately writes only two start-level FIFO words; it therefore does not produce a defined 5-us DAC-output recovery interval. The observed long/variable line-head hold can depend on FIFO drain, line-end fall, and when State 14 next accepts a laser edge. The existing ETH ILA proves scan-delay counting but lacks `dacx_tk_point_cnt` and FIFO-full probes, so it cannot yet prove the reported eight-step loss. State 12/13 is also a likely source of the terminal discontinuity because the fall divisor uses `dax_fall_time + 1` while the state machine performs `dax_fall_time` decrements and then returns to the exact start anchor. No RTL changes made. |
| 2026-08-05 | DL5 full-line diagnostic ILA | Added debug-only full-line probes for accepted laser events, State 12 tail entry, X index, recovery count, FIFO write/read/empty status, DAX/DAY, end marker, acquisition timing, and the actual active-low `camera_line_sync` that drives TRIGGER_H. The first fully-routed diagnostic image passed post-route repair (WNS +0.043 ns, WHS +0.049 ns), but it lacked the direct camera probe; before user download, `ila_2/probe0` was reassigned from already-tested blanker to camera sync. A final full implementation is now required; functional RTL/FIFO/register/IO behavior remains unchanged. |
| 2026-08-05 | DL5 full-line diagnostic build qualified | Final full build with direct `camera_line_sync` probe completed. Its initial route had WNS=-0.152 ns and was not delivered. One checkpoint-based physical optimization/re-route produced WNS=+0.189 ns, WHS=+0.053 ns, DRC 0 error/0 critical warning, and the matched `DL5_UNIT_006/out/bitstream/ETH_TOP_dl5_dax_diag.bit/.ltx`. Added a guarded three-ILA capture script for full line/state/FIFO, DAX tail/camera, and acquisition delay/time; board capture awaits user programming. |
| 2026-08-05 | DL5 diagnostic ILA resource optimization | Rejected the first timing-qualified diagnostic bit because BRAM rose from the 404.5/445 baseline to 429.5/445 (96.52%, +6.2%). Split the 4096-sample ETH ILA into a dedicated `ila_dl5_eth` core and restored shared `ila_1` to 1024 samples; retained all probe signals. Final full build PASS: WNS +0.105 ns, WHS +0.051 ns, BRAM 414.5/445 (93.15%, +2.5%), DRC 0 error/0 critical warning. The paired bit/LTX are ready; board capture still awaits user programming. |
| 2026-08-05 | DL5 artifact-boundary check | Feature-package validation now has the required simulation-replay disclaimer and `out/sim/` marker. Project-managed runs necessarily leave `.jou` under read-only `AXI_DDR.runs/`. Root `vivado.log` and `vivado_pid18956.str` are held by the user's open Vivado GUI PID 18956, so they were neither moved nor deleted; the current unit already contains its independent batch logs/reports. |
| 2026-08-05 | DL5 diagnostic board capture | Downloaded resource-optimized diagnostic bit was captured with all three ILA cores. Initial live readback was not the required 16x16 profile (`dac_sample=50`, 1688 X points, recovery/fall=300 us, scan delay=80 ns); after an authorized stop/configure/readback/start sequence, final 16x16 triggers prove 16 accepted laser events and X indices 0..15 with no write-side loss, 800 ns State15 delay, and correct 20 ns acquisition delay/time. DAC code falls monotonically from the last pixel to start (no digital narrow spike); the next visible X increment is ~6.74 us after the return, confirming the existing State2 FIFO-recovery contract problem. `camera_line_sync` stayed high for all 4096 DAC samples despite line-end markers, so camera sync is recorded as a new unresolved functional defect. See `DL5_UNIT_006/BOARD_VERIFICATION.md` and timestamped CSV evidence. |
| 2026-08-05 | DL5 post-capture package check | Work-package validator PASS (optional stage-directory warnings only). Spill scan continues to report the user's open Vivado GUI PID 18956 working areas under `.Xil/` and `AXI_DDR.hw/`, plus locked root GUI logs; these historical/user-owned paths were preserved. Every guarded board-capture manifest reports `NEW_DROOT_SPILL_COUNT=0`; new board evidence remains inside `DL5_UNIT_006/out/ila/`. |
| 2026-08-05 | DL5 final-pixel spike interpretation correction | Re-read the DAC ILA at the bit33 line-end boundary. The apparent final narrow spike is present in the digital stream: penultimate X code `0xD8BD` holds 2 us, while final X code `0xE664` lasts only four DAC clocks (80 ns) before the monotonic fall begins. The write-side ILA still proves all sixteen indices 0..15 were produced; the observable waveform contains 15 normal laser-held plateaus plus a short final-pixel pulse. |
| 2026-08-05 | DL5 dwell/latency interpretation correction | Corrects the provisional conclusions in the earlier scope/capture records: the final `x=15` point was not under-written by RTL. The diagnostic profile deliberately set `dac_sample=4`, and ILA proves State 16 wrote all four words; 80 ns is therefore the configured DAC dwell (`4 × 20 ns`). For a 1 us host dwell, `0x0002` must be 50 and the FIFO model predicts a 600 ns drain, safely below the 2 us laser period. The 6.74 us post-fall interval also cannot alone prove State 2 recovery-count failure. Current ILA proves only laser-to-FIFO-write = 808 ns; the previously scoped laser-to-DAX ≈1.2 us has not yet been independently measured by ILA because the captured clocks/triggers lack a common event timestamp. |
| 2026-08-05 | DL5 dac_sample=50 recapture and camera root cause | With user authorization, stopped scan, verified `0x0002=0x00000032`, and restarted scan at `0x00003211`; all other laser-test registers remained unchanged. Guarded three-ILA event capture (`20260805_144245`) shows all x=0..15 State16 segments run 50 cycles and final DAX `0xE664` holds exactly 50 DAC clocks (1.000 us) before monotonic fall, proving the configured dwell without FIFO overrun. `camera_line_sync` remains high for all 4096 DAC samples although line-end bit33 occurs twice. Combined ILA/RTL evidence locates an off-by-one: laser bit34 line-start is combinational at State16/count0 while the registered FIFO `wr_en` becomes active on the following word, so bit34 is never written; bit33 is also early relative to the final word. No RTL changed; camera fix must align both markers with actual FIFO words. |
| 2026-08-05 | DL5 normal-mode camera-sync control capture | Applied the checked 16×16 normal-mode profile (`0x020B=0`, `0x0202=0`, `dac_sample=50`, recovery=5 us, X fall=1 us, scan active `0x00003211`) and ran a guarded DAC-ILA snapshot. `camera_line_sync` is low for each complete 800-sample / 16.000-us valid-pixel line and high for the 300-sample / 6.000-us fall-plus-recovery interval; DAX concurrently traverses all 16 1-us steps. Thus TRIGGER_H wiring, DAC-domain output, and normal-mode bit32 semantics pass; the identified defect is exclusive to laser FIFO bit34/bit33 timing. |
| 2026-08-05 | DL5 scope CSV / ILA correlation | Reviewed scope CSV `0909010017/0018`: CH1 is a continuous 2-us laser input (1-us high), while CH2 shows the DAX tail and visible staircase. Current readback remains the 16x16 laser profile. A guarded live ILA capture (`20260805_190455`) proves x=0 is accepted after recovery and x increments once per accepted laser edge; DAC ILA shows all 16 codes (x0..x15) and a 31-us active-low camera window. The CSV alone cannot identify the first accepted start-code block because that block equals the held X-start level; do not derive a 14.2-us recovery interval solely from the first visible DAX step. No RTL, register, or bitstream change. |
| 2026-08-05 | DL5 laser profile reapply | After user reprogrammed the FPGA image, reapplied and read back the oscilloscope/ILA profile: `dac_sample=50`, 16x16, DAX `0x1999..0xE665`, X recovery 5 us, fall 1 us, scan delay 800 ns, blanker 80/500 ns, acquisition delay/time 20/20 ns, laser mode enabled, and scan start `0x00003211`. |
| 2026-08-06 | DL5 acquisition-ILA profile reapply | Reapplied the checked laser profile before user observes `hw_ila_18`: 16x16, `dac_sample=50`, X recovery/fall 5/1 us, scan delay 800 ns, blanker 80/500 ns, acquisition delay/time 20/20 ns (`0x0209/0x020A=1/1`), laser enable `0x020B=1`, scan active `0x00003211`. All listed registers read back successfully. |
| 2026-08-06 | DL5 2-us DAC-echo CSV check | Analyzed raw scope exports `0909010088` (laser/CH1) and `0909010089` (DAX/CH2) at 1 ns sampling. DAX stage transitions occur once at 0.480, 2.480, ... 18.480 us; every in-window stage has exactly 1.241 us latency from its preceding laser rise and advances by about 1.04 V. No second same-code DAX sequence exists at +2 us. The one observed flyback is 819 ns by 90-to-10-percent crossings. No RTL, register, or bitstream change. |
| 2026-08-06 | DL5 post-download acquisition-ILA configuration | After user reprogrammed the FPGA, reapplied the 16x16 laser observation profile and read back `0x0002=50`, `0x0004=16x16`, `0x0006=16 points/5 us`, `0x000F=1 us`, `0x0206/0207/0208=100/16/100`, `0x0209/020A=1/1` (20/20 ns), `0x020B=1`, and scan active `0x00003211`. The mode helper's initial stop readback was raced by an in-flight scan packet, but its retry stopped the scan and all subsequent writes/readbacks passed. User's Vivado screenshot simultaneously shows no discoverable debug cores, so `hw_ila_18` is empty until the Hardware Manager target is reconnected and the matched debug bit/LTX is programmed. |
| 2026-08-06 | DL5 acquisition ILA semantic review | Read `dac_output.v` with the live `hw_ila_18` capture. `dl5_ila_acq_counts={acq_delay_cnt[15:0],acq_time_cnt[15:0]}` and `dl5_ila_acq_status={laser_mode_en_ui,acq_pulse_ui,acq_state[1:0]}`; the observed high-half 0..3 then low-half 0..3 proves 20 ns/20 ns relative to accepted `laser_pulse_ui`. This is not external-laser-to-ADC-trigger latency: the physical input crosses eth_clk via three FFs, is accepted by State14 and sent as a toggle, then crosses ui_clk via three FFs before that ILA signal. `adc_tri` is subsequently sampled into dac_dco. Consequently the physical end-to-end delay is longer and phase-dependent; `acq_time=1` is intentionally useful for this timing proof but violates the RTL's documented robust-operation requirement `acq_time>=2` (40 ns) for the ui-to-dac_dco crossing. |
| 2026-08-06 | DL5 historical ILA end-to-end audit | Re-read the prior ILA capture scripts, board records, and live probe wiring. Historical captures proved the functional chain in separate clock domains: `hw_ila_21`/`ila_dl5_eth` captures raw `laser_sync_in` and the eth event/toggle; `hw_ila_18` captures UI `laser_pulse_ui`; the ADC-domain ILA captures `adc_tri_r1` and `acq_en` (historically `adc_tri_r1` sample 512, `acq_en` from 515). No existing ILA has raw `laser_sync_in` and final dac-domain `adc_tri` in one common clocked capture, so it cannot derive an exact pin-to-output delay. The current DAC ILA exposes FIFO[32], not final laser-mode `adc_tri`; scope is also unavailable because `adc_tri` has no physical output. |
