meryglez529-commits/DAHUASUO/AI-work/features/camera_line_sync/DL1_UNIT_002/SCOPE_REVIEW.md

# DL1_UNIT_002：示波器 CSV 复核

## 输入与限制

- 用户提供：`F:/smart/csvwave/0909010011.csv`、`F:/smart/csvwave/0909010013.csv`。
- 两份文件分别只标为 `CH1` 与 `CH2`，不含探头实际接线名称；本文将 CH1=外部激光输入、CH2=DAX 作为与波形形状相符的条件性解释，仍需用户确认接线。
- 导出文件的 `GenTime` 相差约 18 s，且示波器日期为 2009-09-01。因此不能把两份 CSV 的零时刻用于测量激光到 DAX 的相对延迟，也不能据此验证相机同步。

## CH1：`0909010011.csv`

- 采样间隔 1 ns，70 µs 记录长度。
- 电平约为 -1.76 V / +1.68 V。
- 上升沿依次位于 0.359、2.359、4.359 µs …；周期 2.000 µs，高电平宽度 1.000 µs。

若 CH1 接的是外部激光输入，则它与本次 ILA 所见 2 µs 激光周期一致，未见丢脉冲或周期漂移。

## CH2：`0909010013.csv`

- 采样间隔 1 ns，70 µs 记录长度。
- 在稳定段可见 16 个等间隔 DAX 电平，约为 -4.00、-3.44、-2.92、-2.40、-1.88、-1.32、-0.80、-0.28、0.24、0.76、1.28、1.80、2.32、2.84、3.36、3.92 V；相邻级差约 0.52 V。
- 相邻 DAX 台阶间隔 2.000 µs。例：21.6、23.6、25.6 … 49.6 µs。
- 16 个像素对应 16 个稳定电平，但仅有 15 个可见的相邻电平跃迁。首像素 x0 的 DAX=-4.00 V 与回扫终点相同，故 x0 已开始时模拟输出不产生新的阶跃；从 x0 到 x15 的 15 次跃迁正是示波器可数到的 15 个台阶。
- 49.6 µs 的末点后，约在 50.64…51.60 µs 回扫至 -4.00 V，回扫约 0.96 µs；下一行的首点与回扫终点同为 -4.00 V，因而在模拟波形上不出现新的阶跃。
- 相邻行首 marker 的推导周期约 36 µs = 31 µs 有效像素窗口 + 5 µs 行间隔。该 5 µs 是当前激光模式的实测行尾到下一行首总间隔，其中包含约 1 µs 回扫；用户已确认这不符合“回扫后额外恢复 5 µs”的需求，属待修 RTL 缺陷。

若 CH2 接的是 DAX，则该波形正是预期形状：每次激光到来推进一个 X 点；行尾从 +3.92 V 快速回扫到 -4.00 V；行首恢复期间保持在 -4.00 V。行尾的大幅回扫不是额外尖峰，也不是少写点。

用户在同屏实时测量的激光上升沿到可见 DAX 阶跃约为 1.24 µs。该值与当前 `scan_delay=100` 的定义一致：State15 在 FPGA 已同步识别的 laser 边沿后等待 100×8 ns=800 ns，随后才开始向异步 FIFO 写像素 word；从写入到模拟 DAX 阶跃还会经历 CDC、FIFO 读侧、`rd_en_r` 输出寄存器和模拟 DAC 建立。两个独立 CSV 的时间零点不能单独证明此绝对延时，但可用于确认每 2 µs 的重复节奏。

## 当前不能由此确认的内容

1. 相机同步 `TRIGGER_H` 未出现在两份 CSV 中，不能评价其低有效窗口。
2. 两个 CSV 不是同一时间基准导出，不能用来测量激光边沿到 DAX 台阶的绝对延迟。
3. 若 CH1/CH2 实际接线与上述假设不同，则需按实际接线重新解释。

## 建议的下一次示波器采集

一次同时采集并导出三路：CH1=外部激光输入、CH2=DAX、CH3=`TRIGGER_H`（相机同步），触发选择 CH1 上升沿、时基 5 µs/div。通过条件：

- CH3 低电平从首个有效 DAX=-4.00 V 点开始，连续覆盖 16 个台阶（约 31 µs）；
- CH3 在 DAX 从 +3.92 V 开始回扫时恢复高电平；
- CH2 的相邻有效台阶约 2 µs，行周期约 36 µs。
