meryglez529-commits/DAHUASUO/AI-work/features/DL5_laser_sync/DL5_UNIT_005/RELIABILITY_REVIEW.md

# DL5 激光 blanker 可靠性审查（2026-08-04）

## 结论

当前 bitstream 在完整的停扫、配置、使能、启动流程下已经实测通过：`laser_sync_in`、CDC、`laser_pulse_ui_1`、`adc_tri_r1` 和 `acq_en` 正常。因此不存在“当前输入信号一直进不了 FPGA”的故障。

但现有实现存在三个会造成产品现场“普通模式正常、激光/blanker 无波形或表现不稳定”的可靠性风险。其中协议地址漂移是已证实的产品兼容性问题；另外两个是 RTL 防御性不足，尚未证明就是本次历史现象的唯一原因。

## 处理决定

用户决定先完成整体测试；本审查中列出的协议兼容、复位、zero-width 和模式互锁问题均记录为**待后续修复**，本轮不修改 RTL、XDC、IP 或上位机行为，也不将其标记为已关闭。

## 已证实：旧上位机与当前寄存器表不兼容（P1）

| 项目 | 旧资料/旧上位机语义 | 当前 RTL 语义 | 后果 |
|---|---|---|---|
| `0x0205` | `laser_mode_en` | `sync2_pixel_tri_wigth` | 写 `0x0205=1` 不会使能激光模式 |
| `0x020B` | 未使用或旧版未覆盖 | `laser_mode_en` | 未写该地址时，激光路径保持关闭 |

证据：当前 `command_monitor_new.v` 写 case 明确将 `0x020B` 连接到 `laser_mode_en`，并将 `0x0205` 连接到 sync2 宽度；当前 project host-app 已使用 `0x020B`。历史工作包和旧资料仍有将 `0x0205` 解释为激光使能的记录。

这与现场“旧上位机普通扫描正常、激光模式无输出”的症状完全相符。下一次复现时应对旧上位机做 192.168.1.8:32000 的窄范围 UDP 抓包，确认它是否实际写入 `0x020B=1`，而不是只写 `0x0205=1`。

## 高风险 RTL 缺陷：blanker 状态没有完整复位（P2）

`dac_output.v` 的 sync1/blanker 状态机复位分支复位了 `sync1_state` 和计数器，但没有显式复位 `sync_pixel_tri1_reg`。激光模式下物理 `TRIG_BLANK` 输出为该寄存器的反相。

这会使复位释放、激光模式使能与第一个激光事件之间存在未定义启动状态风险；虽然 IDLE 分支会在后续时钟清零，设计不应依赖该隐含收敛。

## 高风险 RTL 缺陷：zero-width 下溢（P1）

当 `blanker_delay_time > 0` 且 `blanker_time = 0` 时，sync1 的 S2 状态比较 `sync1_width_used - 1`。32 位无符号下溢后比较目标为 `0xFFFF_FFFF`，blanker 内部高有效窗口会持续约 2^32 个 200 MHz 时钟（约 21.5 秒）；物理低有效 `TRIG_BLANK` 则被拉低约 21.5 秒。

该组合未被当前 host-app 的 `Dl5Config.validate()` 拒绝。产品语义应明确为：宽度为 0 时禁用该脉冲，而不是进入长时间异常窗口。

## 架构风险：切换流程只靠上位机约定（P1）

设计文档要求“停扫描 -> 改 `laser_mode_en`/参数 -> 启动扫描”，以借助启动复位清理跨时钟状态机。RTL 当前没有拒绝运行时切换、没有 mode-ready/status 位，也没有原子 apply/ack 机制。不同版本上位机、网络重试或用户仅点“开始”都可能使状态机处于非预期阶段。

## 建议的修复与验证顺序

1. **协议兼容门禁（优先）**：旧上位机在启动前读取版本/寄存器映射；不支持 `0x020B` 时禁止进入激光模式并明确报错。抓取旧上位机一次真实会话，作为最终根因证据。
2. **RTL 防御性修复**：在 sync1 复位/默认分支显式清 `sync_pixel_tri1_reg`；对 `blanker_time=0` 定义为禁用，避免 S2 的减一操作；对 acq/其他类似宽度同样做零值审查。
3. **模式切换互锁**：在硬件中仅接受 scan stopped 时的 mode/时序参数更新，或提供 apply/ready/status 握手；上位机显示 FPGA 已确认的当前模式。
4. **回归**：覆盖冷启动、激光/普通/超快切换、`blanker_time={0,1,100}`、中途网络重发、旧地址 `0x0205=1`、正确地址 `0x020B=1`。

在上述修复完成并经仿真、实现、示波器/ILA 验证前，当前产品状态应标记为“功能已验证，鲁棒性未关闭”。
