meryglez529-commits/DAHUASUO/user_src/OV5640_IIC/prj/OV5640_IIC.runs/synth_1/.vivado.begin.rst

<?xml version="1.0"?>
<ProcessHandle Version="1" Minor="0">
    <Process Command="vivado.bat" Owner="Administrator" Host="123TJY" Pid="29188">
    </Process>
</ProcessHandle>
