meryglez529-commits/DAHUASUO/大化所新方案设计.pdf

# 大化所新方案设计

背景：

大化所客户需求：将飞秒激光器作为跨时域四维电镜的统一激发光源，飞秒激光器发送脉冲 信号给采集卡，进而控制SEM的束闸偏转和信号采集

一、系统架构

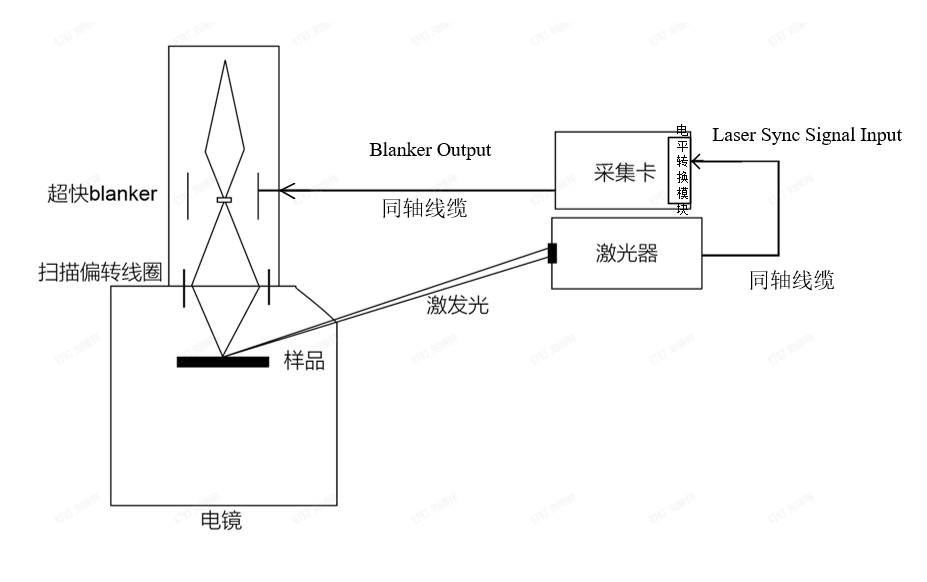
[picture p1: figure]

二、拍照流程

（1）上位机设置必要的采集参数，各个延时时间，选择合适的驻点时间，点击下发参

数，上位机反馈参数是否设置合理。

（2）正确设置参数后，开启飞秒激光器

（3）点击扫描图像

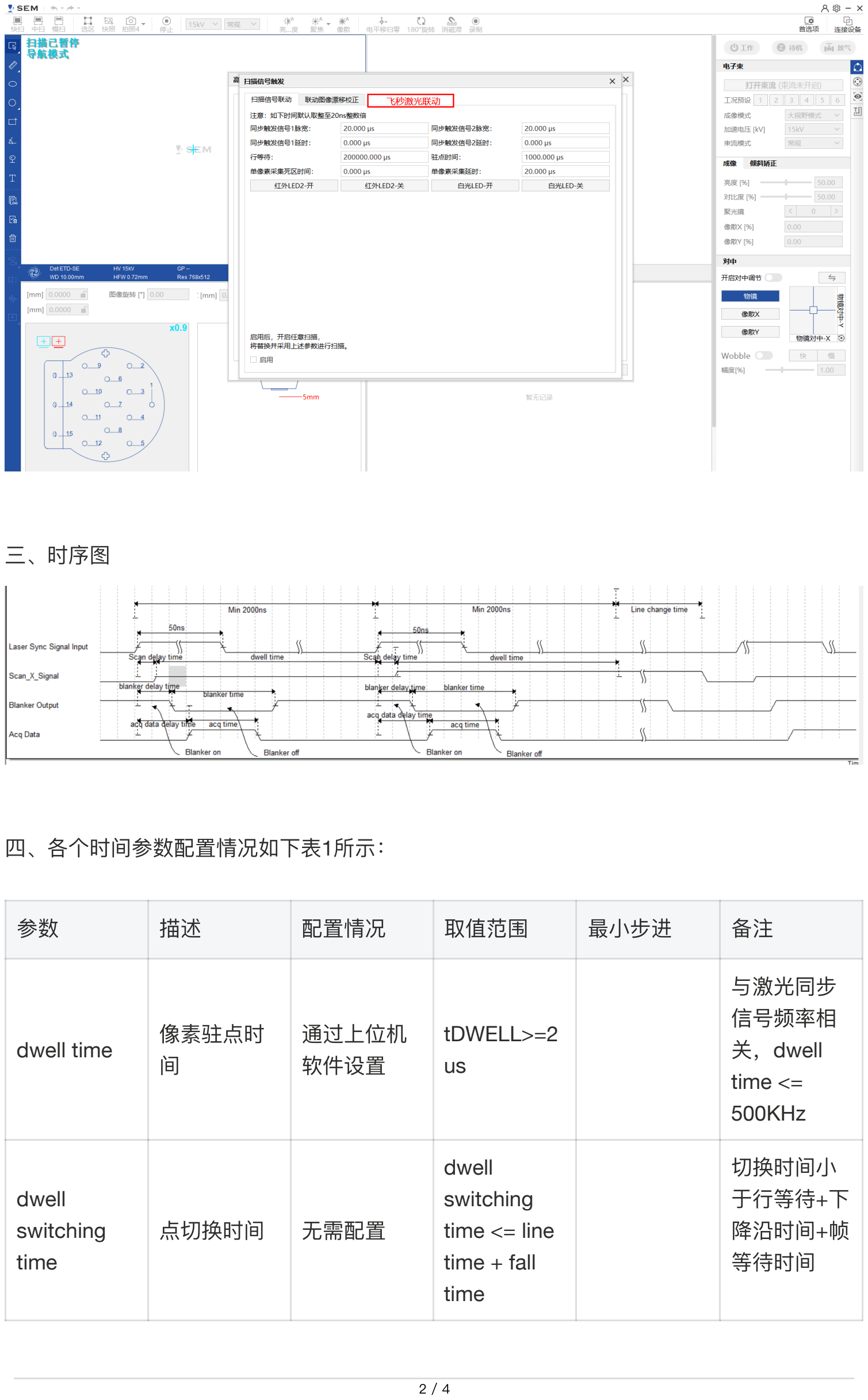
[picture p2: page 2]

三、时序图

四、各个时间参数配置情况如下表1所示：

参数 | 描述 | 配置情况 | 取值范围 | 最小步进 | 备注
dwell time | 像素驻点时 间 | 通过上位机 软件设置 | tDWELL>=2 us | | 与激光同步 信号频率相 关，dwell time <= 500KHz
dwell switching time | 点切换时间 | 无需配置 | dwell switching time <= line time + fall time | | 切换时间小 于行等待+下 降沿时间+帧 等待时间

五、输入输出信号

六、待讨论

1、blanker束闸的最小步进为5ns，驻点时间延时、采集数据延时最小为20ns

2、激光输出的同步信号接口是SMA

3、需要将探测器模块邮寄合肥进行改装，来回时间大概为5-6天（主要是快递时间）

4、原来ns激光器和blanker 联用功能是否继续保存

5、方案确认后，完成验证时间1~2周

### 2.5V转3.3V模块

blanker delay time | 束闸延时间 | 通过上位机 软件设置 | 5ns | blanker delay time+blanke r time <= 激 光频率
blanker time | 束闸保持时 间 | 通过上位机 软件设置 | 5ns
acq data delay time | 采集延时时 间 | 通过上位机 软件设置 | 20ns | acq data delay time+acq time <= 激 光频率
acq time | 像素采集时 间 | 通过上位机 软件设置 | 20ns
Line change time | 行切换时间 | 无需配置 | | 行扫切换结 束后，接收 到触发信号 开始采集
输入/输出 | 名称 | 触发/电平
input | Laser Sync Signal Input | 高电平触发，2.5V TTL
output | Blanker Output | 可选高低电平触发， 3.3VTTL

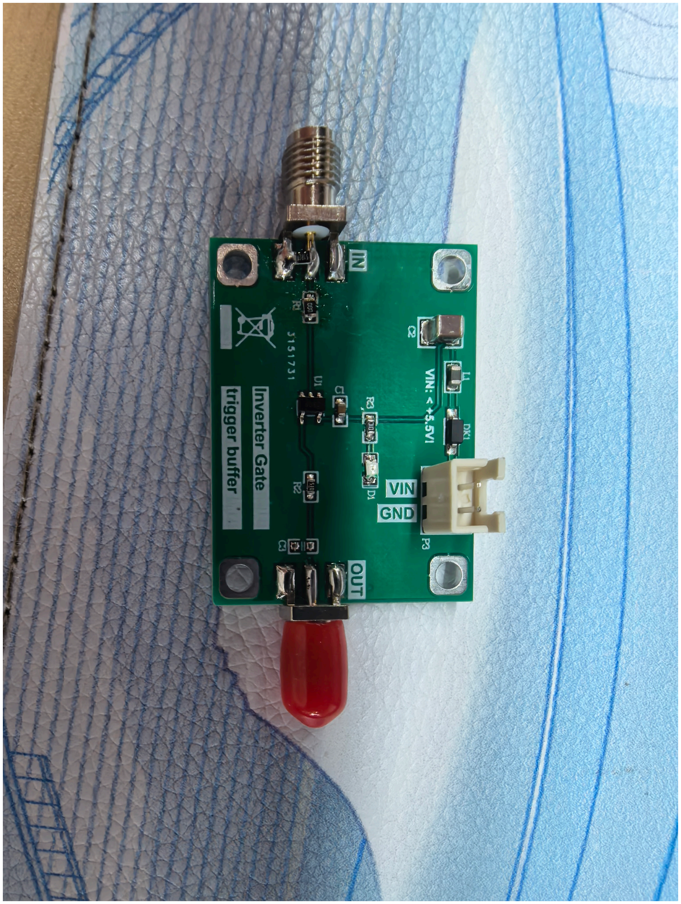
[picture p3: figure]
