meryglez529-commits/DAHUASUO/AI-work/guide/FPGA_FLOW_VISUALIZATION.html

# SGSC SEM FPGA 控制与数据流图

基于 FPGA_PROJECT_GUIDE、DL1、DL2、DL4 深读文档整理

总览 控制参数 DAC扫描 ADC采集 时钟缓存

流动动画

控制参数 DAC扫描点 ADC样本 触发同步 DDR/CDC

顶层：ETH_TOP，主时钟域：eth_clk / dac_dco / adc_dco / ui_clk

当前节点

## command_monitor_new

DL4 的集中解码点。它把 `WR_REG_ADDR/DATA` 变成 DL1、DL2、DL3 和 offset 支撑逻辑使用的参数影子寄存器。

eth_clk WR_REG RD_REG_DATA

输入`WR_REG_VALID/ADDR/DATA`，`RD_REG_VALID/ADDR`

输出`scan_state`、`adc_sample`、`dac_sample`、`ultrafast_mode` 等

证据`command_monitor_new.v:191-281`

### 高价值结论

控制参数是 DL1/DL2 的共同源头。`0x0002` 同时写 `dac_sample` 和 `adc_sample`，`0x0009` 同时写 `adc_interval/scan_mode/scan_state`。`0x0200` 在代码中重复定义，sync2 宽度需要重点核对。

### 参考文档

FPGA_PROJECT_GUIDE.md：全工程链路地图 DL1_DAC_SCAN_DEEP_READ.md：DAC扫描、触发、sync输出 DL2_ADC_DDR_ETH_DEEP_READ.md：ADC采集、DDR、UDP回传 DL4_REG_CONTROL_DEEP_READ.md：寄存器控制链路

### 寄存器参数扇出

地址 | 参数 | 去向 | 作用
0x0002 | dac_sample, adc_sample | DL1 DL2 | 每点停留和ADC平均数绑定
0x0004 | image_row, image_column | DL1 DL2 | 扫描尺寸和总点数
0x0005-0x0007 | dacx_*, dacy_* | DL1 | 起止电平、恢复时间和步进重算
0x0009 | adc_interval, scan_mode, scan_state | CTRL | 采样间隔、模式和启停
0x0202 | ultrafast_line_rec, ultrafast_mode | DL1 DL2 | 快速模式改变DAC恢复和ADC采样策略

### ADC数据形态

位置 | 位宽 | 含义 | 变化
AD9258输入 | 4 x 14 | 顶层取 [15:2] | 外设样本进入FPGA
adcdata_acq | 16 | 按 adc_sample 平均后的点 | adc_dco 到 ui_clk
adcdata_get | 64 | 按 adc_channel 聚合 | 1/2/4路打包
FDMA/MIG | 64 | DDR用户侧beat | 128 beat一包
LAN_TX_FREAME | 8 | UDP payload字节 | 64到8宽度转换

### 关键CDC/缓存

结构 | 写时钟 | 读时钟 | 数据
fifo_generator_4 | eth_clk | dac_dco | 35-bit DAC参数流
fifo_generator_1 | adc_dco | ui_clk | 16-bit ADC平均点
fifo_generator_3 | ui_clk | ui_clk | 64-bit ADC写DDR缓存
DDR3/MIG | ui_clk | ui_clk | ADC大容量缓存
fifo_generator_9 | ui_clk | eth_clk | 64-bit到8-bit发包桥
