meryglez529-commits/DAHUASUO/AI-work/features/camera_line_sync/DL1_UNIT_002/BOARD_VERIFICATION.md

# DL1_UNIT_002：激光相机行同步板级 ILA 验证

## 1. 执行信息

- 日期：2026-08-05。
- 固件：`out/bitstream/ETH_TOP_camera_marker_fix.bit`，与同名 `.ltx` 匹配。
- 板卡版本读回：`0x000300AC`。
- 上位机按停止扫描→写参数→启动扫描顺序下发；所有写入均读回一致。激光使能读回 `0x020B=1`，扫描状态读回 `0x0009=0x00003211`。
- ILA 使用受保护启动器 `AI-work/scripts/run_vivado_ila_guarded.ps1`，三组核均触发；`spill_manifest.txt` 记录 `new_droot_spill_count=0`。

## 2. 本次参数

| 项目 | 写入值 | 实际时间/含义 |
|---|---:|---|
| 图形 | X=16，Y=16 | 每行 16 个激光触发像素 |
| `dac_sample` | 50 | 1 µs（50 MHz DAC） |
| 行首恢复参数 `dacx_recovery_time` | 5 | 普通模式的定义为额外 5 µs 恢复；激光模式实际物理时序见第 3.2 节 |
| 扫描延时 `0x0206` | 100 | 800 ns（8 ns/步） |
| 束闸延时 `0x0207` | 20 | 100 ns（5 ns/步） |
| 束闸宽度 `0x0208` | 80 | 400 ns（5 ns/步） |
| 采集延时 `0x0209` | 30 | 600 ns（20 ns/步） |
| 采集宽度 `0x020A` | 60 | 1.2 µs（20 ns/步） |

外部激光上升沿的实测 ILA 周期为 250 个 `eth_clk` 周期，即 2 µs。

## 3. 证据与判定

### 3.1 写侧整行

`eth_full_line_TRIG_20260805_162219.csv` 以 `dl5_dbg_line_start_accept` 触发：

- State14 接收起始激光脉冲后，State15 正好持续 100 个 `eth_clk` 周期；State16 从样本 101 开始。
- State16 的 X 计数为 0…15，16 个点全部存在；每个点连续 50 个 `eth_clk` 周期。
- 所有 State16 样本 `prog_full=0`，未见 FIFO 反压、少写或少点。

判定：写侧没有“只写 8 点/末点缺失”的问题。

### 3.2 DAC、marker 与相机同步

`dac_camera_alignment_TRIG_20260805_162219.csv` 的 `para_config_dout_1[34:33]` 中，`2` 表示 FIFO[34] 行首 marker，`1` 表示 FIFO[33] 行尾 marker。ILA 样本均为 DAC 上升沿变更前的寄存器观察值。

| DAC ILA 样本 | DAX | FIFO[34:33] | 观察到的相机状态 | 后一 DAC 边沿后的结果 |
|---:|---:|---:|---:|---|
| 1523 | `0x1999` | `2`（行首） | 高/未激活 | 1524 起相机低，开始有效像素行 |
| 3072 | `0xE664` | `1`（行尾） | 低/激活 | 3073 仍低，覆盖末点 |
| 3074 | `0xE260` | `0`（回扫首码） | 高/未激活 | 有效行结束，不覆盖回扫 |

同一捕获中，完整行的相机低电平观察样本为 1524…3073，共 1550 个 DAC 采样（31 µs）。该长度符合当前外部激光 2 µs 周期下的 15 个像素间隔（30 µs）加末点 `dac_sample=50` 的 1 µs 驻留。首点和行首恢复电平码都为 `0x1999`，因此必须以 marker/状态而不能仅以码值判定边界。

需区分参数名与当前激光模式的实测物理时间：源代码将 `dacx_recovery_time=5` 换算为 250，但 State2 在激光模式只写两个锚点 word，并以 125 MHz `eth_clk` 跑完 250 个计数，即内部仅 2 µs。当前 ILA 的行尾 marker（样本 1272）到下一行首 marker（样本 1523）为 251 个 DAC 采样，约 5.02 µs；其中约 1 µs 是 X 回扫，回扫完成到下一行首 marker 约静止 4 µs。因此此配置实测的是“回扫加等待总计约 5 µs”，不是回扫之外稳定保证 5 µs。这是激光模式的参数语义偏差，尚未修改 RTL。

判定：修复后的 FIFO[34] 与第一个有效 DAX word 对齐，FIFO[33] 与最后一个有效 DAX word 对齐；低有效相机同步完整覆盖一行有效像素区，行尾在回扫开始时释放。

### 3.3 采集时序

`acq_timing_TRIG_20260805_162219.csv` 在样本 512、912 等捕获到 `laser_pulse_ui`，相邻脉冲相隔 400 个 `ui_clk` 周期（2 µs）。每个脉冲后：

- `ACQ_DELAY` 从样本 513 计至 632，共 120 个 `ui_clk` 周期 = 600 ns；
- `ACQ_HIGH` 从样本 633 计至 872，共 240 个 `ui_clk` 周期 = 1.2 µs。

判定：采集延时和宽度与下发的 `30/60` 完全一致。

## 4. 归档文件

- `out/ila/eth_full_line_TRIG_20260805_162219.csv` / `.vcd`
- `out/ila/dac_camera_alignment_TRIG_20260805_162219.csv` / `.vcd`
- `out/ila/acq_timing_TRIG_20260805_162219.csv` / `.vcd`
- `out/ila/capture_laser_camera_alignment_20260805_162216.log`
- `out/ila/spill_manifest.txt`

## 5. 结论与剩余测试

本次 ILA 已闭环验证激光模式相机行同步错位修复。当前板卡保持激光扫描运行；下一步可在示波器上测量 TRIGGER_H 的实际低有效电平，并与 DAX/DAY、束闸和 ADC 触发进行外部接口级确认。

用户已确认产品需求：激光模式也必须保持“物理回扫完成后额外恢复 `dacx_recovery_time`，此期间不响应下一行首个 laser”的语义。故当前 State2 的激光模式计时/供数策略是已确认缺陷，后续需要修改并重新完成 FIFO、时序与板级验证。
