meryglez529-commits/DAHUASUO/AXI_DDR.srcs/sources_1/ip/MSXBO_OVSensorRGB565_0/synth/MSXBO_OVSensorRGB565_0.v

// (c) Copyright 1995-2019 Xilinx, Inc. All rights reserved.
// 
// This file contains confidential and proprietary information
// of Xilinx, Inc. and is protected under U.S. and
// international copyright and other intellectual property
// laws.
// 
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
// CRITICAL APPLICATIONS
// Xilinx products are not designed or intended to be fail-
// safe, or for use in any application requiring fail-safe
// performance, such as life-support or safety devices or
// systems, Class III medical devices, nuclear facilities,
// applications related to the deployment of airbags, or any
// other applications that could lead to death, personal
// injury, or severe property or environmental damage
// (individually and collectively, "Critical
// Applications"). Customer assumes the sole risk and
// liability of any use of Xilinx products in Critical
// Applications, subject only to applicable laws and
// regulations governing limitations on product liability.
// 
// THIS COPYRIGHT NOTICE AND DISCLAIMER MUST BE RETAINED AS
// PART OF THIS FILE AT ALL TIMES.
// 
// DO NOT MODIFY THIS FILE.


// IP VLNV: xilinx.com:user:MSXBO_OVSensorRGB565:1.0
// IP Revision: 5

(* X_CORE_INFO = "MSXBO_OVSensorRGB565,Vivado 2017.4" *)
(* CHECK_LICENSE_TYPE = "MSXBO_OVSensorRGB565_0,MSXBO_OVSensorRGB565,{}" *)
(* CORE_GENERATION_INFO = "MSXBO_OVSensorRGB565_0,MSXBO_OVSensorRGB565,{x_ipProduct=Vivado 2017.4,x_ipVendor=xilinx.com,x_ipLibrary=user,x_ipName=MSXBO_OVSensorRGB565,x_ipVersion=1.0,x_ipCoreRevision=5,x_ipLanguage=VERILOG,x_ipSimLanguage=MIXED,CMOS_FRAME_WAITCNT=1111}" *)
(* DowngradeIPIdentifiedWarnings = "yes" *)
module MSXBO_OVSensorRGB565_0 (
  cmos_clk_i,
  rst_n_i,
  cmos_pclk_i,
  cmos_href_i,
  cmos_vsync_i,
  cmos_data_i,
  cmos_xclk_o,
  rgb_o,
  de_o,
  vs_o,
  hs_o
);

input wire cmos_clk_i;
input wire rst_n_i;
input wire cmos_pclk_i;
input wire cmos_href_i;
input wire cmos_vsync_i;
input wire [7 : 0] cmos_data_i;
output wire cmos_xclk_o;
output wire [31 : 0] rgb_o;
output wire de_o;
output wire vs_o;
output wire hs_o;

  MSXBO_OVSensorRGB565 #(
    .CMOS_FRAME_WAITCNT('B1111)
  ) inst (
    .cmos_clk_i(cmos_clk_i),
    .rst_n_i(rst_n_i),
    .cmos_pclk_i(cmos_pclk_i),
    .cmos_href_i(cmos_href_i),
    .cmos_vsync_i(cmos_vsync_i),
    .cmos_data_i(cmos_data_i),
    .cmos_xclk_o(cmos_xclk_o),
    .rgb_o(rgb_o),
    .de_o(de_o),
    .vs_o(vs_o),
    .hs_o(hs_o)
  );
endmodule
