meryglez529-commits/DAHUASUO/AXI_DDR.srcs/sources_1/imports/imports/SGMII_TEMAC_fifo_block.v

//------------------------------------------------------------------------------
// File       : SGMII_TEMAC_fifo_block.v
// Author     : Xilinx Inc.
// -----------------------------------------------------------------------------
// (c) Copyright 2004-2013 Xilinx, Inc. All rights reserved.
//
// This file contains confidential and proprietary information
// of Xilinx, Inc. and is protected under U.S. and
// international copyright and other intellectual property
// laws.
//
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
// CRITICAL APPLICATIONS
// Xilinx products are not designed or intended to be fail-
// safe, or for use in any application requiring fail-safe
// performance, such as life-support or safety devices or
// systems, Class III medical devices, nuclear facilities,
// applications related to the deployment of airbags, or any
// other applications that could lead to death, personal
// injury, or severe property or environmental damage
// (individually and collectively, "Critical
// Applications"). Customer assumes the sole risk and
// liability of any use of Xilinx products in Critical
// Applications, subject only to applicable laws and
// regulations governing limitations on product liability.
//
// THIS COPYRIGHT NOTICE AND DISCLAIMER MUST BE RETAINED AS
// PART OF THIS FILE AT ALL TIMES.
// -----------------------------------------------------------------------------
// Description: This is the FIFO Block level vhdl wrapper for the Tri-Mode
//              Ethernet MAC core.  This wrapper enhances the standard MAC core
//              with an example FIFO.  The interface to this FIFO is
//              designed to the AXI-S specification.
//              Please refer to core documentation for
//              additional FIFO and AXI-S information.
//
//         _________________________________________________________
//        |                                                         |
//        |                 FIFO BLOCK LEVEL WRAPPER                |
//        |                                                         |
//        |   _____________________       ______________________    |
//        |  |  _________________  |     |                      |   |
//        |  | |                 | |     |                      |   |
//  -------->| |   TX AXI FIFO   | |---->| Tx               Tx  |--------->
//        |  | |                 | |     | AXI-S            PHY |   |
//        |  | |_________________| |     | I/F              I/F |   |
//        |  |                     |     |                      |   |
//  AXI   |  |     10/100/1G       |     |  TRI-MODE ETHERNET   |   |
// Stream |  |    ETHERNET FIFO    |     |          MAC         |   | PHY I/F
//        |  |                     |     |     SUPPORT LEVEL    |   |
//        |  |  _________________  |     |                      |   |
//        |  | |                 | |     |                      |   |
//  <--------| |   RX AXI FIFO   | |<----| Rx               Rx  |<---------
//        |  | |                 | |     | AXI-S            PHY |   |
//        |  | |_________________| |     | I/F              I/F |   |
//        |  |_____________________|     |______________________|   |
//        |                                                         |
//        |_________________________________________________________|

`timescale 1 ps/1 ps


//------------------------------------------------------------------------------
// The module declaration for the FIFO Block level wrapper.
//------------------------------------------------------------------------------

(* DowngradeIPIdentifiedWarnings = "yes" *)
module SGMII_TEMAC_fifo_block (
      input         gtx_clk,
      
      // asynchronous reset
      input         glbl_rstn,
      input         rx_axi_rstn,
      input         tx_axi_rstn,

      // Receiver Statistics Interface
      //---------------------------------------
      output        rx_mac_aclk,
      output        rx_reset,
      output [27:0] rx_statistics_vector,
      output        rx_statistics_valid,

      // Receiver (AXI-S) Interface
      //----------------------------------------
      input         rx_fifo_clock,
      input         rx_fifo_resetn,
      
      output [7:0]  rx_axis_fifo_tdata,
      
      output        rx_axis_fifo_tvalid,
      input         rx_axis_fifo_tready,
      output        rx_axis_fifo_tlast,
      // Transmitter Statistics Interface
      //------------------------------------------
      output        tx_mac_aclk,
      output        tx_reset,
      input  [7:0]  tx_ifg_delay,
      output [31:0] tx_statistics_vector,
      output        tx_statistics_valid,


      // Transmitter (AXI-S) Interface
      //-------------------------------------------
      input         tx_fifo_clock,
      input         tx_fifo_resetn,
      
      input  [7:0]  tx_axis_fifo_tdata,
      
      input         tx_axis_fifo_tvalid,
      output        tx_axis_fifo_tready,
      input         tx_axis_fifo_tlast,

      // MAC Control Interface
      //------------------------
      input         pause_req,
      input  [15:0] pause_val,

      // GMII Interface
      //-----------------
      output [7:0]  gmii_txd,
      output        gmii_tx_en,
      output        gmii_tx_er,
      input  [7:0]  gmii_rxd,
      input         gmii_rx_dv,
      input         gmii_rx_er,
      input         clk_enable,
      output        speedis100,
      output        speedis10100,
      // Configuration Vectors
      //-----------------------
      input  [79:0] rx_configuration_vector,
      input  [79:0] tx_configuration_vector,

      output [7:0] rx_axis_mac_tdata_out,
      output       rx_axis_mac_tvalid_out,
      output       rx_axis_mac_tlast_out,
      output       rx_axis_mac_tuser_out,

      output [7:0] tx_axis_mac_tdata_out,
      output       tx_axis_mac_tvalid_out,
      output       tx_axis_mac_tready_out,
      output       tx_axis_mac_tlast_out,
      output       tx_axis_mac_tuser_out
   );


  //----------------------------------------------------------------------------
  // Internal signals used in this fifo block level wrapper.
  //----------------------------------------------------------------------------

  wire       rx_mac_aclk_int;    // MAC Rx clock
  wire       tx_mac_aclk_int;    // MAC Tx clock
  wire       rx_reset_int;       // MAC Rx reset
  wire       tx_reset_int;       // MAC Tx reset

  // MAC receiver client I/F
  wire [7:0] rx_axis_mac_tdata;
  wire       rx_axis_mac_tvalid;
  wire       rx_axis_mac_tlast;
  wire       rx_axis_mac_tuser;

  // MAC transmitter client I/F
  wire [7:0] tx_axis_mac_tdata;
  wire       tx_axis_mac_tvalid;
  wire       tx_axis_mac_tready;
  wire       tx_axis_mac_tlast;
  wire       tx_axis_mac_tuser;

  assign  rx_axis_mac_tdata_out  = rx_axis_mac_tdata; 
  assign  rx_axis_mac_tvalid_out = rx_axis_mac_tvalid;
  assign  rx_axis_mac_tlast_out  = rx_axis_mac_tlast;
  assign  rx_axis_mac_tuser_out  = rx_axis_mac_tuser;

  assign  tx_axis_mac_tdata_out  = tx_axis_mac_tdata; 
  assign  tx_axis_mac_tvalid_out = tx_axis_mac_tvalid;
  assign  tx_axis_mac_tready_out = tx_axis_mac_tready;
  assign  tx_axis_mac_tlast_out  = tx_axis_mac_tlast; 
  assign  tx_axis_mac_tuser_out  = tx_axis_mac_tuser;  

  //----------------------------------------------------------------------------
  // Connect the output clock signals
  //----------------------------------------------------------------------------

  assign rx_mac_aclk          = rx_mac_aclk_int;
  assign tx_mac_aclk          = tx_mac_aclk_int;
  assign rx_reset             = rx_reset_int;
  assign tx_reset             = tx_reset_int;

  //----------------------------------------------------------------------------
  // Instantiate the Tri-Mode Ethernet MAC Support Level wrapper
  //----------------------------------------------------------------------------
  SGMII_TEMAC_support trimac_sup_block (
      .gtx_clk              (gtx_clk),
      

      // asynchronous reset
      .glbl_rstn            (glbl_rstn),
      .rx_axi_rstn          (rx_axi_rstn),
      .tx_axi_rstn          (tx_axi_rstn),

      // Receiver Interface
      .rx_statistics_vector (rx_statistics_vector),
      .rx_statistics_valid  (rx_statistics_valid),

      .rx_mac_aclk          (rx_mac_aclk_int),
      .rx_reset             (rx_reset_int),
      .rx_axis_mac_tdata    (rx_axis_mac_tdata),
      .rx_axis_mac_tvalid   (rx_axis_mac_tvalid),
      .rx_axis_mac_tlast    (rx_axis_mac_tlast),
      .rx_axis_mac_tuser    (rx_axis_mac_tuser),

      // Transmitter Interface
      .tx_ifg_delay         (tx_ifg_delay),
      .tx_statistics_vector (tx_statistics_vector),
      .tx_statistics_valid  (tx_statistics_valid),

      .tx_mac_aclk          (tx_mac_aclk_int),
      .tx_reset             (tx_reset_int),
      .tx_axis_mac_tdata    (tx_axis_mac_tdata ),
      .tx_axis_mac_tvalid   (tx_axis_mac_tvalid),
      .tx_axis_mac_tlast    (tx_axis_mac_tlast),
      .tx_axis_mac_tuser    (tx_axis_mac_tuser ),
      .tx_axis_mac_tready   (tx_axis_mac_tready),

      // Flow Control
      .pause_req            (pause_req),
      .pause_val            (pause_val),

      // Speed Control
      .clk_enable           (clk_enable),
      .speedis100           (speedis100),
      .speedis10100         (speedis10100),

      // GMII Interface
      .gmii_txd             (gmii_txd),
      .gmii_tx_en           (gmii_tx_en),
      .gmii_tx_er           (gmii_tx_er),
      .gmii_rxd             (gmii_rxd),
      .gmii_rx_dv           (gmii_rx_dv),
      .gmii_rx_er           (gmii_rx_er),

      // Configuration Vector
      .rx_configuration_vector (rx_configuration_vector),
      .tx_configuration_vector (tx_configuration_vector)
   );


   //----------------------------------------------------------------------------
   // Instantiate the user side FIFO
   //----------------------------------------------------------------------------

   // locally reset sync the mac generated resets - the resets are already fully sync
   // so adding a reset sync shouldn't change that
   SGMII_TEMAC_reset_sync rx_mac_reset_gen (
      .clk                  (rx_mac_aclk_int),
      .enable               (1'b1),
      .reset_in             (rx_reset_int),
      .reset_out            (rx_mac_reset)
   );

   SGMII_TEMAC_reset_sync tx_mac_reset_gen (
      .clk                  (tx_mac_aclk_int),
      .enable               (1'b1),
      .reset_in             (tx_reset_int),
      .reset_out            (tx_mac_reset)
   );

   // create inverted mac resets as the FIFO expects AXI compliant resets
   assign tx_mac_resetn = !tx_mac_reset;
   assign rx_mac_resetn = !rx_mac_reset;


   
   SGMII_TEMAC_ten_100_1g_eth_fifo #
   (
      .FULL_DUPLEX_ONLY     (1)
   )
   
   user_side_FIFO
   (
      // Transmit FIFO MAC TX Interface
      .tx_fifo_aclk           (tx_fifo_clock),
      .tx_fifo_resetn         (tx_fifo_resetn),
      .tx_axis_fifo_tdata     (tx_axis_fifo_tdata),
      .tx_axis_fifo_tvalid    (tx_axis_fifo_tvalid),
      .tx_axis_fifo_tlast     (tx_axis_fifo_tlast),
      .tx_axis_fifo_tready    (tx_axis_fifo_tready),
      

      .tx_mac_aclk            (tx_mac_aclk_int),
      .tx_mac_resetn          (tx_mac_resetn),
      .tx_axis_mac_tdata      (tx_axis_mac_tdata),
      .tx_axis_mac_tvalid     (tx_axis_mac_tvalid),
      .tx_axis_mac_tlast      (tx_axis_mac_tlast),
      .tx_axis_mac_tready     (tx_axis_mac_tready),
      .tx_axis_mac_tuser      (tx_axis_mac_tuser),

      .tx_fifo_overflow       (),
      .tx_fifo_status         (),
      .tx_collision           (1'b0),
      .tx_retransmit          (1'b0),

      .rx_fifo_aclk           (rx_fifo_clock),
      .rx_fifo_resetn         (rx_fifo_resetn),
      .rx_axis_fifo_tdata     (rx_axis_fifo_tdata),
      .rx_axis_fifo_tvalid    (rx_axis_fifo_tvalid),
      .rx_axis_fifo_tlast     (rx_axis_fifo_tlast),
      .rx_axis_fifo_tready    (rx_axis_fifo_tready),
      .rx_mac_aclk            (rx_mac_aclk_int),
      .rx_mac_resetn          (rx_mac_resetn),
      .rx_axis_mac_tdata      (rx_axis_mac_tdata),
      .rx_axis_mac_tvalid     (rx_axis_mac_tvalid),
      .rx_axis_mac_tlast      (rx_axis_mac_tlast),
      .rx_axis_mac_tuser      (rx_axis_mac_tuser),

      .rx_fifo_status         (),
      .rx_fifo_overflow       ()
  );


endmodule
