meryglez529-commits/DAHUASUO/(commit log)

2026-05-22 DL5 design v3: femtosecond laser sync acquisition mode (architecture)
    Per customer 大化所 requirement (AXI_DDR.srcs/大化所新方案设计.md):
    external femtosecond laser pulse becomes time master; FPGA generates
    blanker + acq windows per pulse, switches pixel at the end of each
    laser period (方案 B).
    Key v3 decisions (user-approved):
    - 200MHz clock: ui_clk (MIG, already routed) — not clk200m (sysclk PLL)
    - blanker polarity: low-active (reuse existing sync_pixel_tri1 ~ inversion path)
    - acq_data_delay_time: NEW independent register (different from 0x0201
    adc_acq_delay; this one is ui_clk-domain controlling adc_tri rising
    edge delay, the existing one is adc_dco-domain controllin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
2026-05-22 DL5 impl: femtosecond laser sync acquisition mode (RTL + unit sim + synth)
    New module:
    - laser_sync_blanker_ctrl.v: ui_clk-domain 3-state FSM (IDLE/BUSY/DONE)
    + 3-stage FF sync for async laser_sync_in + rising-edge detect
    + parallel blanker / acq window comparators
    + scan_state gating (idles when scan_state=0)
    + pixel_done_pulse at t_cnt == laser_period - 1
    Modified RTL (5 files):
    - parameter_dacdata_gen.v: State 3 adds laser_mode branch with
    laser_pixel_written one-shot flag (write 1 FIFO word per pixel,
    then wait pixel_done_pulse). Old mode unchanged.
    - dac_output.v: 4 new inputs (laser_mode_en, blanker_pulse,
    laser_acq_pulse, laser_event_busy) + 3 muxes (adc_tri / sync1 /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
2026-05-28 revert DL5 RTL: restore all source files to pre-DL5 baseline
    - Reverted ETH_TOP.v, command_monitor_new.v, dac_output.v,
    dacdata_config.v, parameter_dacdata_gen.v, AXI_DDR.xpr
    to f54c298 (design doc commit, before RTL changes)
    - Deleted laser_sync_blanker_ctrl.v and its testbench
    (DL5-only new files)
    - AI-work documentation preserved for reference
    [ETH_TOP.v, command_monitor_new.v, dac_output.v, dacdata_config.v, parameter_dacdata_gen.v]
2026-06-01 DL5 laser sync mode: RTL, sim docs, and host app
    Add DL5 laser sync implementation notes, simulation replay assets, host-app prototype, Vivado sim setup, and updated RTL/project wiring.
    Clean staged whitespace and update AI-work ignore rules for Python caches and virtualenvs.
2026-06-03 DL5 上板调试闭环：修复 host-app 扫描几何 + 定位 D15 硬件问题
    上板调试发现 blanker 无输出，逐层定位出两个独立问题并全部解决：
    1. host-app 漏写 DAC 扫描几何寄存器（导致普通模式 DAC 也无波形）
    - ScanConfig.to_registers() 只写 0x0001/0x0002/0x0004/0x0009，
    从不写 0x0005/0x0006/0x0007/0x000F
    - 写 0x0006 是 FPGA 触发 dacx_step 除法器的唯一时机，不写则
    dacx_step 恒为复位值，DAX 恒 0x8000
    - 修复：scan.py 增加 X/Y 几何字段（固定内置默认值），
    modes.py 补全标签，三模式共用 _scan_items()，21 单测通过
    2. D15/laser_sync_in 外部输入无信号（板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
    [ETH_TOP.v, dac_output.v, dacdata_config.v, modes.py, parameter_dacdata_gen.v, scan.py, tb_dl5_unit_002.v]
2026-06-05 DL5 UNIT004 laser acquisition verification
2026-06-11 feat(host-app): align command monitor params and redesign GUI
    [command_monitor_new.v, connection_bar.py, device.py, dl5.py, log_panel.py]
2026-08-03 fix(dl5): wait for laser trigger before next ADC acquisition
    [adcdata_acq.v, dac_output.v, dl5_unit_005_stubs.v, tb_dl5_unit_005_adc_trigger_wait.v]
2026-08-03 feat(host-app): add DL2 ADC imaging receiver
2026-08-03 docs(dl1): add camera line-sync work package
2026-08-04 feat(dl1): add active-low camera line sync output
    - Reuse TRIGGER_H without changing FIFO width, XDC, or IP\n- Preserve normal, ultrafast, and laser legacy sync behavior
2026-08-04 test(dl1): add camera line sync simulation harness
    - Cover normal, ultrafast, laser gap, and laser end timing\n- Keep simulation and synthesis evidence unit-local
2026-08-04 docs(dl1): record camera sync verification status
    - Capture simulation and elaboration PASS evidence\n- Record independent synthesis timing failure and handoff boundary
2026-08-04 build(dl1): archive camera sync bitstream
2026-08-04 docs(dl5): record legacy laser protocol mismatch
2026-08-04 docs(dl5): record live laser register readback
2026-08-04 debug(dl5): add guarded laser input ILA capture
2026-08-04 verify(dl5): capture host-driven laser chain
2026-08-05 docs(dl5): record dac output connector mapping
2026-08-05 docs(dl5): record acquisition timing ILA evidence
    - Record restored laser test profile and UI/ADC acquisition timing capture\n- Add guarded DAX anomaly ILA inventory and capture scripts\n\nCo-Authored-By: Claude Opus 4.7 (1M context) <noreply@anthropic.com>
2026-08-05 docs(dl5): record laser DAX root-cause analysis
    - Record recovery contract violation and terminal fall discontinuity risk\n- Distinguish proven scan delay from unproven step-loss mechanism\n\nCo-Authored-By: Claude Opus 4.7 (1M context) <noreply@anthropic.com>
2026-08-05 Add full-line laser diagnostic ILA probes
    - Capture laser line acceptance, FIFO flow, DAX tail, camera sync, and acquisition timing\n- Expand diagnostic ILA depth for a complete 16-pixel line\n\nCo-Authored-By: Claude Opus 4.7 (1M context) <noreply@anthropic.com>
2026-08-05 Document DL5 DAX diagnostic build
    - Record scope, probe map, timing evidence, and board-debug plan\n- Preserve the qualified bitstream handoff and open diagnosis questions\n\nCo-Authored-By: Claude Opus 4.7 (1M context) <noreply@anthropic.com>
2026-08-05 Add guarded DL5 diagnostic capture workflow
    - Build matched diagnostic bitstream and post-route timing repair\n- Capture line state, DAX tail/camera sync, and acquisition timing together\n\nCo-Authored-By: Claude Opus 4.7 (1M context) <noreply@anthropic.com>
2026-08-05 Isolate full-line ILA to recover BRAM margin
    - Move 4096-sample ETH capture to a dedicated ILA core\n- Restore UI ILA to 1024 samples while preserving probe coverage
2026-08-05 Document resource-optimized DL5 ILA workflow
    - Record qualified timing/resource evidence and artifact boundaries\n- Align the guarded three-ILA capture script with final probe depths
2026-08-05 Record DL5 board-level diagnostic evidence
    - Capture and document full-line, DAC-tail, and acquisition ILA results\n- Add bounded snapshot capture mode for reliable board evidence
2026-08-05 Correct DL5 final-pixel ILA interpretation
    - Identify the 80 ns final X-pixel pulse before the line fall\n- Distinguish 16 generated points from 15 laser-held plateaus
2026-08-05 Record DL5 dwell50 and camera ILA evidence
2026-08-05 Verify normal-mode camera synchronization
2026-08-05 Plan laser camera sync alignment repair
2026-08-05 Fix laser camera sync marker alignment
    [dac_output.v, dl1_unit_002_stubs.v, parameter_dacdata_gen.v, tb_dl1_unit_002_marker_alignment.v]
2026-08-05 Record laser camera sync ILA verification
2026-08-05 Record laser and DAX scope review
2026-08-05 Clarify laser recovery timing semantics
2026-08-05 Record laser recovery timing defect
2026-08-05 Document laser DAX step and latency analysis
2026-08-05 Document laser recovery root cause
2026-08-05 Fix laser recovery after physical flyback
    [dac_output.v, dacdata_config.v, dl5_unit_007_stubs.v, parameter_dacdata_gen.v, tb_dl5_unit_007.v]
2026-08-05 Verify laser physical recovery on board
